raphaelchang/battman-hardware/README.md

# Battman Hardware

PCB designs and firmware for Battman lithium ion battery management system
