raphaelchang/battman-hardware/BMS/Project Outputs for Battman/BOM/Bill of Materials-Battman.xls

Designator | Quantity | Manufacturer | PartNumber | PackageReference | Description | Layer
BOOT, RESET | 2.0 | C&K Components | PTS810 SJM 250 SMTR LFS | PTS810 | Switch, SPNO Push Button SMD | Top
C1, C3, C4, C26, C33 | 5.0 | Murata | GRM155R70J105KA12D | 0402 | 1uF 6.3V 10% 0402 (1005 Metric) | Top
C2, C23_1, C23_2, C23_3, C23_4, C23_5, C23_6, C23_7, C23_8, C23_9, C23_10, C23_11, C23_12, C38, C39 | 15.0 | Murata | GRM155R62A104KE14D | 0402 | 0.1uF 100V 10% 0402 (1005 Metric) | Top
C5, C13, C14, C32, C34, C35, C40, C41, C42 | 9.0 | Murata | GRM155R70J104KA01D | 0402 | 0.1uF 6.3V 10% 0402 (1005 Metric) | Bottom, Top, Bottom, Bottom, Bottom, Bottom, Bottom, Bottom, Bottom
C6 | 1.0 | Murata | GRM155R60J475ME47D | 0402 | 4.7uF 6.3V 20% 0402 (1005 Metric) | Bottom
C7, C8 | 2.0 | Murata | GRM1555C1H150JA01D | 0402 | 15pF 50V 5% 0402 (1005 Metric) | Bottom
C9, C10, C11, C12, C15 | 5.0 | Murata | GRM155R60J225ME15D | 0402 | 2.2uF 6.3V 20% 0402 (1005 Metric) | Bottom
C16, C17, C18, C19 | 4.0 | Murata | GRM188R6YA106MA73D | 0603 | 10uF 35V 10% 0603 (1608 Metric) | Top
C20, C21 | 2.0 | Taiyo Yuden | UMK316BBJ106ML-T | 1206 | 10uF 50V 20% 1206 (3216 Metric) | Top
C22 | 1.0 | Nichicon | PCR1H181MCL1GS | 1H | 180uF 50V 20% | Top
C23 | 1.0 | Murata | GCM155R71H222KA37D | 0402 | 2.2nF 50V 10% 0402 (1005 Metric) | Top
C24 | 1.0 | Murata | GRJ32DC72A475KE11L | 1210 | 4.7uF 100V 10% 1210 (3225 Metric) | Top
C25 | 1.0 | Murata | GRM155R71H332KA01D | 0402 | 3.3nF 50V 10% 0402 (1005 Metric) | Top
C27 | 1.0 | Murata | GRM32ER70J476KE20L | 1210 | 47uF 6.3V 10% 1210 (3225 Metric) | Top
C28, C29 | 2.0 | Murata | GRM155R60J106ME44D | 0402 | 10uF 6.3V 20% 0402 (1005 Metric) | Bottom
C30 | 1.0 | Murata | GRM188R61H105KAALD | 0603 | 1uF 50V 10% 0603 (1608 Metric) | Bottom
C31, C36 | 2.0 | TDK | C1005X7S2A103K050BB | 0402 | 10nF 100V 10% 0402 (1005 Metric) | Bottom
C37 | 1.0 | Murata | GRM1555C1H102JA01D | 0402 | 1nF 50V 5% 0402 (1005 Metric) | Top
D1 | 1.0 | Central Semiconductor | CMHZ5265B TR | SOD-123 | Zener Diodes 500mW Zener Diode 185mA 58.9V to 2V | Top
D2 | 1.0 | SunLED | XZMDKCBDDG45S-9 | 4-PLCC |  | Bottom
D3 | 1.0 | NXP | PTVS51VS1UTR,115 | SOD-123W |  | Bottom
D4, D7, D13, D19 | 4.0 | Lite-On Inc. | LTST-C193TGKT-5A | 0603 |  | Top
D5 | 1.0 | Fairchild Semiconductor | FSV10120V | TO-277-3 | Schottky Diodes & Rectifiers 10 Amp 120V Schottky Rectifier | Top
D6, D16, D17 | 3.0 | Vishay | SMAJ51A-E3/61 | DO-214AC |  | Bottom
D8_1, D8_2, D8_3, D8_4, D8_5, D8_6, D8_7, D8_8, D8_9, D8_10, D8_11, D8_12 | 12.0 | ON Semiconductor | MM3Z12VT1G | SOD-323 | Zener Voltage Regulator, 300 mW, 2-Pin SOD-323, Tape and Reel | Top
D9_1, D9_2, D9_3, D9_4, D9_5, D9_6, D9_7, D9_8, D9_9, D9_10, D9_11, D9_12 | 12.0 | Lite-On Inc. | LTST-C193TBKT-5A | 0603 |  | Top
D10, D11 | 2.0 | NXP Semiconductors | PMEG6020ER,115 | SOD-123W |  | Top
D12, D15, D18 | 3.0 | Littelfuse | SP4021-01FTG | SOD-323-2 |  | Bottom
D14 | 1.0 | Littelfuse | SP4020-01FTG | SOD-323-2 |  | Bottom
F1, F2, F3, F4, F5, F6 | 6.0 | Schurter | 3413.0332.22 | 1206 | Surface Mount Fuses UST 1206 FUSE 25A F | Bottom
JP1 | 1.0 | JST Sales America, Inc. | B13B-XH-A(LF)(SN) | JST-XH |  | Top
JP2, JP3, JP4 | 3.0 | JST Sales America, Inc. | B2B-PH-K-S(LF)(SN) | JST-PH |  | Top
JP5 | 1.0 | JST Sales America, Inc. | B5B-PH-K-S(LF)(SN) | JST-PH |  | Top
JP6 | 1.0 | Amphenol FCI | 10118192-0001LF | USB - Micro B |  | Top
L1 | 1.0 | Murata | BLM31PG330SN1L | 1206 | EMI Filter Beads, Chips & Arrays 1206 33 OHM | Top
L2 | 1.0 | Bourns | SRP1038A-220M | SRP1038A | 22uH 20% 7A 1038 | Top
L3 | 1.0 | Bourns | SDR0604-220YL | SDR0604 | 22uH 30% 1.1A 0604 | Top
L4 | 1.0 | Murata | LQM21PN2R2MGHL | 0805 | 2.2uH 20% 1.7A 0805 | Bottom
LS1 | 1.0 | CUI, Inc. | CSS-0575A-SMT | 5x5x1.9mm | Magnetic Buzzer Transducer | Bottom
Q1, Q8, Q10, Q11, Q12, Q13 | 6.0 | Diodes Incorporated | BSS123WQ-7-F | SOT-323-3 | N-Channel MOSFET | Bottom
Q2 | 1.0 | Vishay | SIR664DP-T1-GE3 | PowerPAK-8 | N-Channel MOSFET | Top
Q3_1, Q3_2, Q3_3, Q3_4, Q3_5, Q3_6, Q3_7, Q3_8, Q3_9, Q3_10, Q3_11, Q3_12, Q9 | 13.0 | Infineon | BSS84PWH6327XTSA1 | SOT323-3 | P-Channel MOSFET | Bottom
Q4 | 1.0 | Infineon Technologies | IRF7749L1TRPBF | DIRECTFET L8 | N-Channel MOSFET | Bottom
Q5, Q7 | 2.0 | Vishay | SI2309CDS-T1-GE3 | SOT23-3 | P-Channel MOSFET | Top
Q6 | 1.0 | Vishay | SIS862DN-T1-GE3 | PowerPAK-1212-8 | N-Channel MOSFET | Top
R1, R2, R3, R6, R7, R9 | 6.0 | KOA Speer | RK73H1ETTP1004F | 0402 | 1M 0.063W 1% 0402 (1005 Metric) | Top
R4 | 1.0 | KOA Speer | RK73H1ETTP1003F | 0402 | 100K 0.063W 1% 0402 (1005 Metric) | Bottom
R5, R10, R34_1, R34_2, R34_3, R34_4, R34_5, R34_6, R34_7, R34_8, R34_9, R34_10, R34_11, R34_12, R36_1, R36_2, R36_3, R36_4, R36_5, R36_6, R36_7, R36_8, R36_9, R36_10, R36_11, R36_12, R50, R51 | 28.0 | KOA Speer | RK73H1ETTP1000F | 0402 | 100R 0.063W 1% 0402 (1005 Metric) | Top, Bottom, Top, Top, Top, Top, Top, Top, Top, Top, Top, Top, Top, Top, Top, Top, Top, Top, Top, Top, Top, Top, Top, Top, Top, Top, Bottom, Bottom
R8 | 1.0 | KOA Speer | RK73H1ETTP1001F | 0402 | 1K 0.063W 1% 0402 (1005 Metric) | Bottom
R11, R12 | 2.0 | KOA Speer | RK73H1ETTP22R0F | 0402 | 22R 0.063W 1% 0402 (1005 Metric) | Bottom
R13 | 1.0 | KOA Speer | RK73H1ETTP1501F | 0402 | 1K5 0.063W 1% 0402 (1005 Metric) | Bottom
R14, R19, R23, R24, R28, R41, R44, R45, R47, R48, R59, R61 | 12.0 | KOA Speer | RK73H1ETTP1002F | 0402 | 10K 0.063W 1% 0402 (1005 Metric) | Bottom, Top, Bottom, Top, Top, Bottom, Bottom, Bottom, Bottom, Bottom, Bottom, Bottom
R15, R16 | 2.0 | KOA Speer | RK73H1ETTP2201F | 0402 | 2K2 0.063W 1% 0402 (1005 Metric) | Bottom
R17, R18, R40, R52, R62 | 5.0 | KOA Speer | RK73H1ETTP4701F | 0402 | 4K7 0.063W 1% 0402 (1005 Metric) | Bottom
R20, R21 | 2.0 | KOA Speer | RK73H1ETTP4R70F | 0402 | 4R7 0.063W 1% 0402 (1005 Metric) | Bottom
R22, R32 | 2.0 | KOA Speer | RK73H1ETTP2003F | 0402 | 200K 0.063W 1% 0402 (1005 Metric) | Bottom
R25 | 1.0 | Murata | NCP15XH103D03RC | 0402 | NTC 10K 0.5% 0402 (1005 Metric) | Top
R26 | 1.0 | KOA Speer | RK73H1ETTP68R0F | 0402 | 68R 0.063W 1% 0402 (1005 Metric) | Bottom
R27, R57, R60 | 3.0 | Vishay | RCS060310K0FKEA | 0603 | 10K 0.25W 1% 0603 (1005 Metric) | Bottom
R29 | 1.0 | Vishay | RCP0603W2K00GEB | 0603 | 2K 1.5W 2% 0603 (1005 Metric) | Top
R30 | 1.0 | KOA Speer | RK73H1ETTP6981F | 0402 | 6K98 0.063W 1% 0402 (1005 Metric) | Bottom
R31 | 1.0 | Panasonic | ERJ-8CWFR016V | 1206 | 0.016R 1W 1% 1206 (3216 Metric) | Top
R33 | 1.0 | KOA Speer | RK73H1ETTP1502F | 0402 | 15K 0.063W 1% 0402 (1005 Metric) | Bottom
R35_1, R35_2, R35_3, R35_4, R35_5, R35_6, R35_7, R35_8, R35_9, R35_10, R35_11, R35_12 | 12.0 | Panasonic | ERJ-P06J470V | 0805 | 47R 0.5W 5% 0805 (2012 Metric) | Bottom
R37 | 1.0 | KOA Speer | RK73H1ETTP1500F | 0402 | 150R 0.063W 1% 0402 (1005 Metric) | Bottom
R38 | 1.0 | KOA Speer | RK73H1ETTP5102F | 0402 | 51K 0.063W 1% 0402 (1005 Metric) | Bottom
R39, R46, R49 | 3.0 | KOA Speer | RK73H1ETTP1802F | 0402 | 18K 0.063W 1% 0402 (1005 Metric) | Bottom
R42, R43 | 2.0 | Vishay | RCP1206W50R0GEB | 1206 | 50R 2.4W 2% 1206 (3216 Metric) | Top
R53 | 1.0 | Vishay / Dale | WSLP2726L5000FEA | 2726 | Current Sense Resistor, 0.0005R | Top
R54, R55, R56 | 3.0 | KOA Speer | RK73H1ETTP1005F | 0402 | 10M 0.063W 1% 0402 (1005 Metric) | Top
R58 | 1.0 | KOA Speer | RK73H1ETTP1200F | 0402 | 120R 0.063W 1% 0402 (1005 Metric) | Bottom
U1 | 1.0 | Linear Technology | LTC6803IG-3#PBF | TSSOP-44 |  | Top
U2 | 1.0 | STMicroelectronics | STM32F303CBT6 | LQFP-48 |  | Bottom
U3 | 1.0 | Linear Technology | LTC3873ETS8-5#PBF | TSOT-23-8 |  | Top
U4 | 1.0 | Maxim Integrated | MAX5215GUA+ | MSOP-8 | 14 Bit Digital to Analog Converter | Bottom
U5 | 1.0 | Maxim Integrated | MAX17502FATB+T | TDFN-10-EP | Ultra-Small, High-Efficiency, Synchronous Step-Down DC-DC Converter, 4.5 to 60 V, 1 A, -40 to 125 degC, 10-Pin TDFN (T1032N+1), RoHS, Tape and Reel | Top
U6 | 1.0 | Texas Instruments | TPS62291DRVR | WSON-6 | Voltage Regulators - Switching Regulators 2.25MHz 1A Step-Down Cnvrtr 3.3V Output | Bottom
U7 | 1.0 | Texas Instruments | BQ76200PWR | TSSOP-16 | Battery Management Fast high side NCH drive | Bottom
U8 | 1.0 | Texas Instruments | TCAN332DCNR | SOT-23-8 | CAN Interface IC 3.3-V CAN Transceivers with CAN FD (Flexible Data Rate) 8-SOT-23 -40 to 125 | Bottom
U9 | 1.0 | Intersil | ISL28022FUZ-T7A | MSOP-10 |  | Top
U10 | 1.0 | Texas Instruments | PCF85263ATT/AJ | TSSOP-8 | Real Time Clock Real-Time Clock calendar | Bottom
U11 | 1.0 | Macronix | MX25R1635FZUIH0 | USON-8 |  | Bottom
Y1 | 1.0 | ABRACON | ABM3B-8.000MHZ-10-1UT | 2012 |  | Bottom
Y2 | 1.0 | AVX/Kyocera | ST3215SB32768B0HPWB3 | ST3215SB | 32.768kHz ±20ppm Crystal 6pF 60 kOhm -40°C ~ 85°C Surface Mount 2-SMD, No Lead (DFN, LCC) | Bottom
