raphaelchang/battman-hardware/OldVersions/V1/pcb/BMS/BMS.step

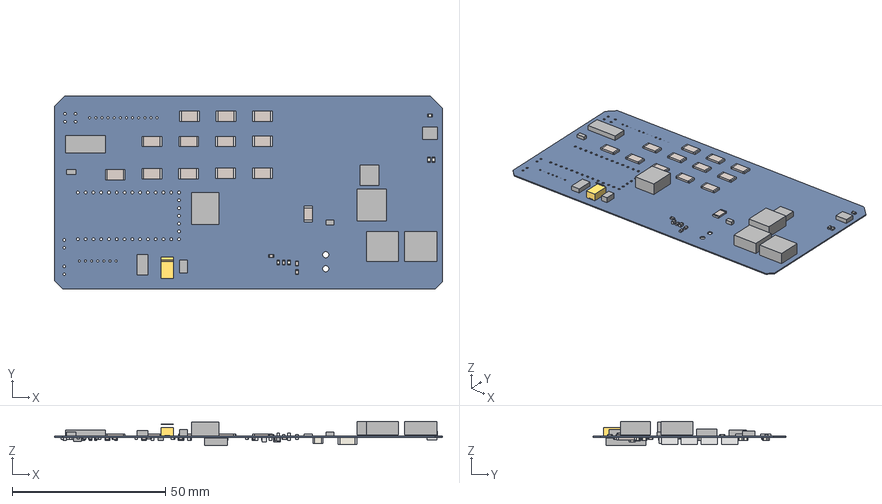
[picture p1: CAD file, 2016-06-15, an earlier design]
OldVersions/V1/pcb/BMS/BMS.step
126.6 x 63.0 x 7.89 mm
Board
Extruded x 319
