raphaelchang/battman-hardware/OldVersions/V3/BMS.step

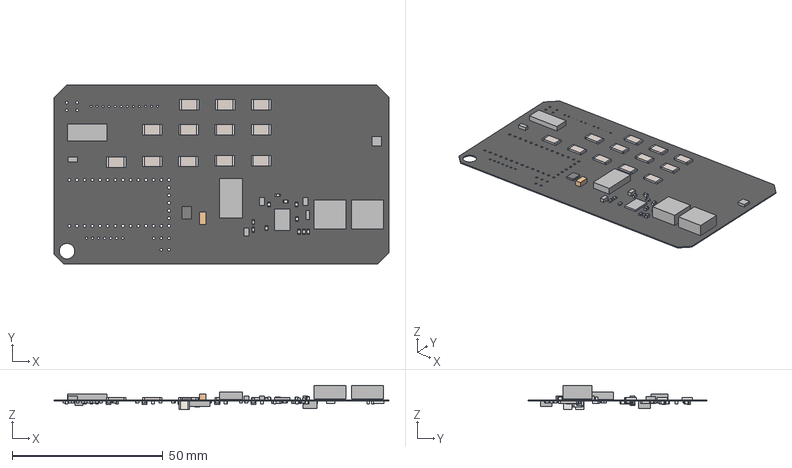
[picture p2: CAD file, 2016-06-15, an earlier design]
OldVersions/V3/BMS.step
111.0 x 59.4 x 8.04 mm
Board
Extruded x 351
User_Library-DFN-12_Leads
User_Library-DFN-12_ComponentBody
