raphaelchang/battman-hardware/(threads)

Thread 1 (2016-09-21):

Is this functional?

pascoej, 2016-09-21:
Does V3 actually work?

brentyi, 2016-09-21:
@pascoej the hardware's pretty much there, but we're working hard on stress testing + firmware development (switched microcontrollers) and won't be releasing until that's all done.

Check back in a few months!

Closed 2016-11-12.

Thread 2 (2016-10-12):

Export as Eagle-friendly ACCEL-ASCII

27percent, 2016-10-12:
Hi there!

I'm really enjoying following this project, the progress you've made over the past couple of weeks is crazy impressive, can't wait to see if the 4.0 PCBs work out!

Since your goal for this project is to be an hobbyist-friendly open-source BMS, could you possibly export the designs from Altium as ACCEL-ASCII or another Eagle compatible format? For better or worse, EagleCAD has become is the de facto standard for open source projects, so it'd be great if eagle-compatible files were available for people to take a look at and base their own designs off :)

raphaelchang, 2016-10-22:
I've added a .PCB file in the project outputs folder, which should be usable by Eagle. I still haven't found a way to export the schematics.

Closed 2016-11-12.

Thread 3 (2017-08-29):

More room between wire pads

Peemouse, 2017-08-29:
Soldering pads are too close for safe soldering and operation in a hard environnement (vibration, shock...) that may result into shorts.

Please, make more room between pads or split them to different place on the board.
This is a major issue and may result is serious hazard.

Thread 4 (2017-08-29):

Protect board from wrong connecting order

Peemouse, 2017-08-29:
As you mention, we need to connect battery first and then balance plugs.
Not respecting this procedure results into frying component on the board.

Please, improve this point to make the board more robust to any wiring order (this would happen a lot).

Thread 6 (2018-03-27):

Specifications

happytm, 2018-03-27:
What are the specifications for this board? specially compared to http://electrodacus.com/SBMS100/manual/SBMSmanual.pdf

brentyi, 2018-03-27:
We haven't actively pushed the limits of the board, but the components are specced for:
- 100A continuous discharge, 150A peak
- Support for 4S ~ 12S lithium batteries
- 100mA balancing current
- CC/CV charging at 6A

happytm, 2018-03-27:
Thanks
