raphaelchang/battman-hardware/OldVersions/V3/BMS.pdf

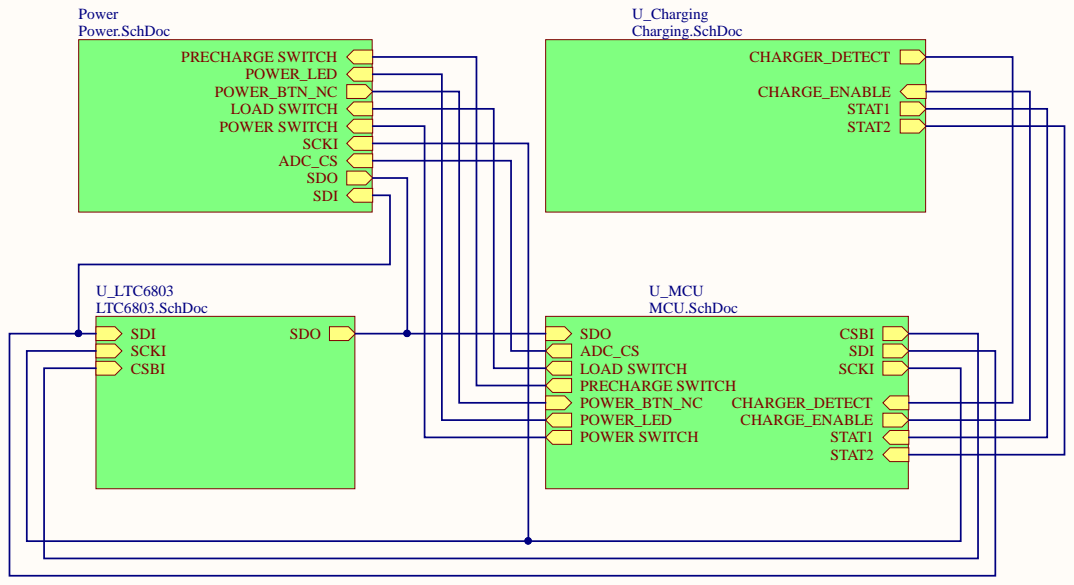
[picture p3: page 1]

Raphael Chang & Brent Yi

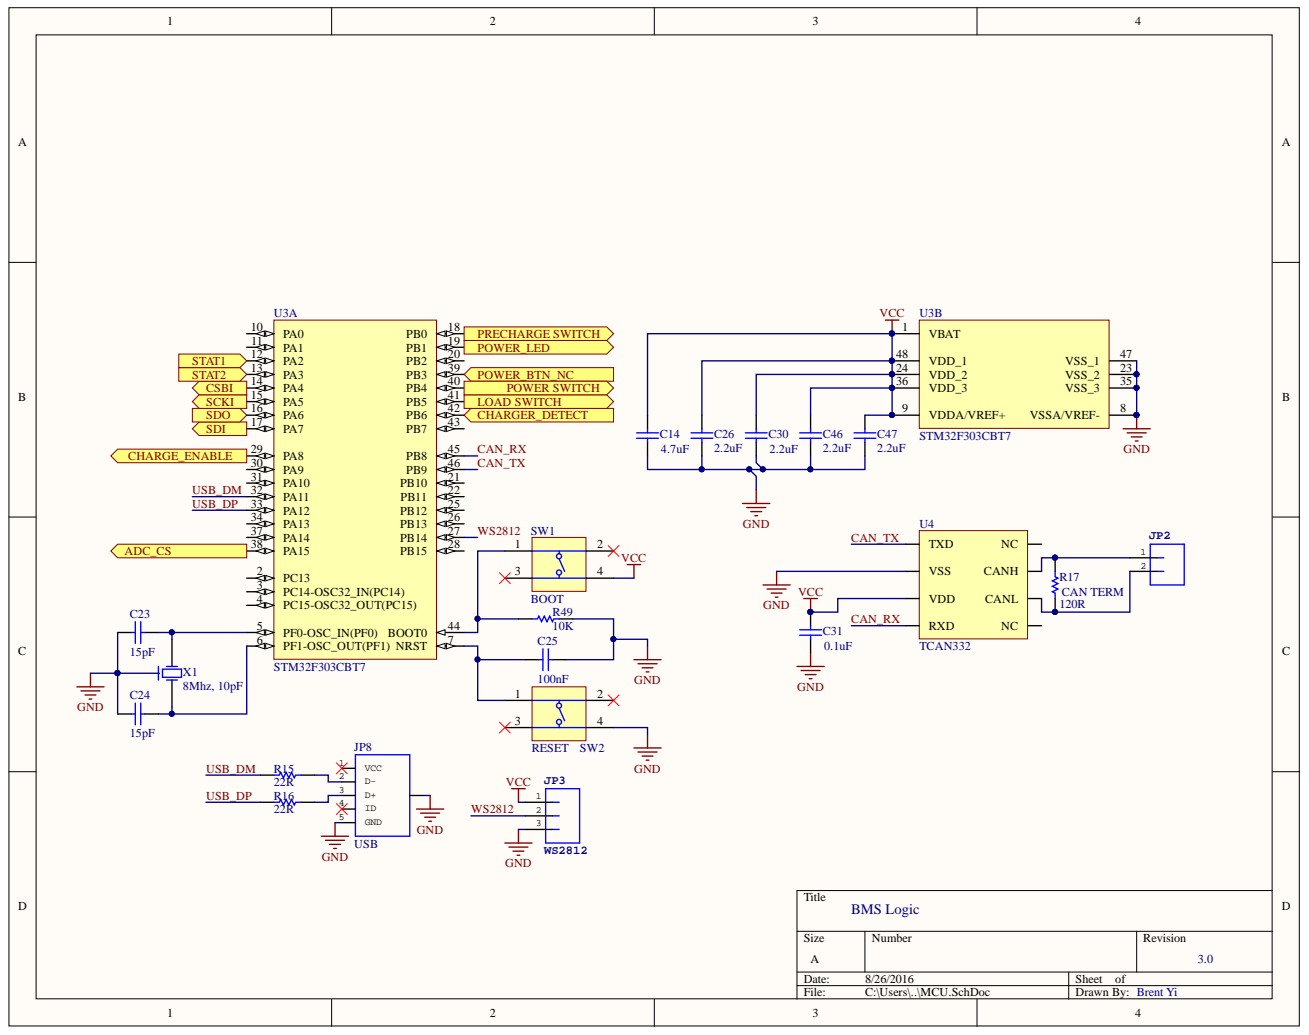
[picture p4: page 2]

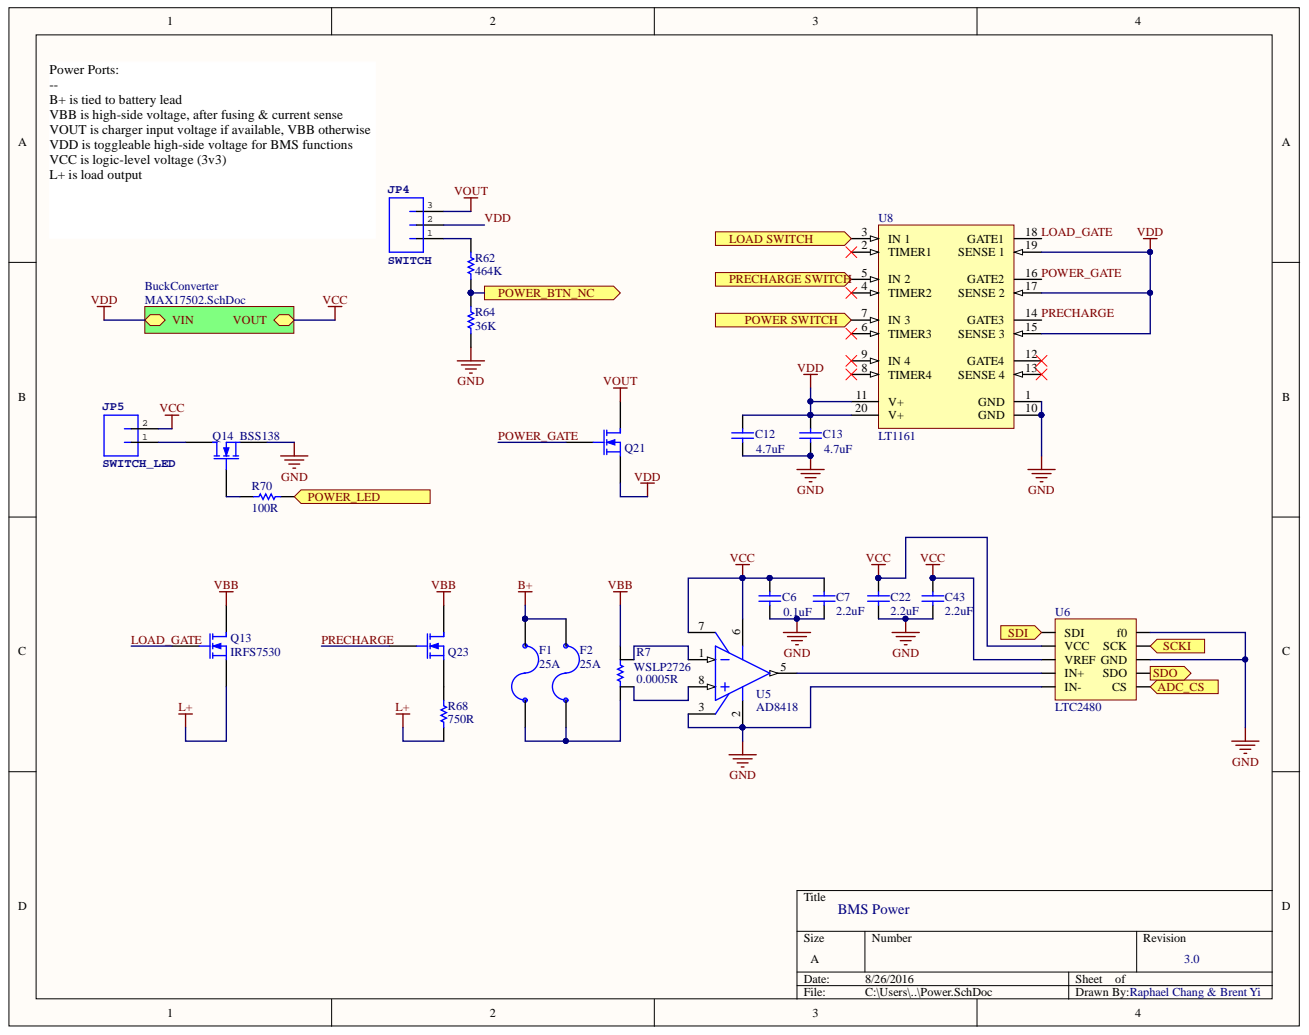
[picture p5: page 3]

Power Ports:
B+ is tied to battery lead
VBB is high-side voltage, after fusing & current sense
VOUT is charger input voltage if available, VBB otherwise
VDD is toggleable high-side voltage for BMS functions
VCC is logic-level voltage (3v3)
L+ is load output

Raphael Chang & Brent Yi

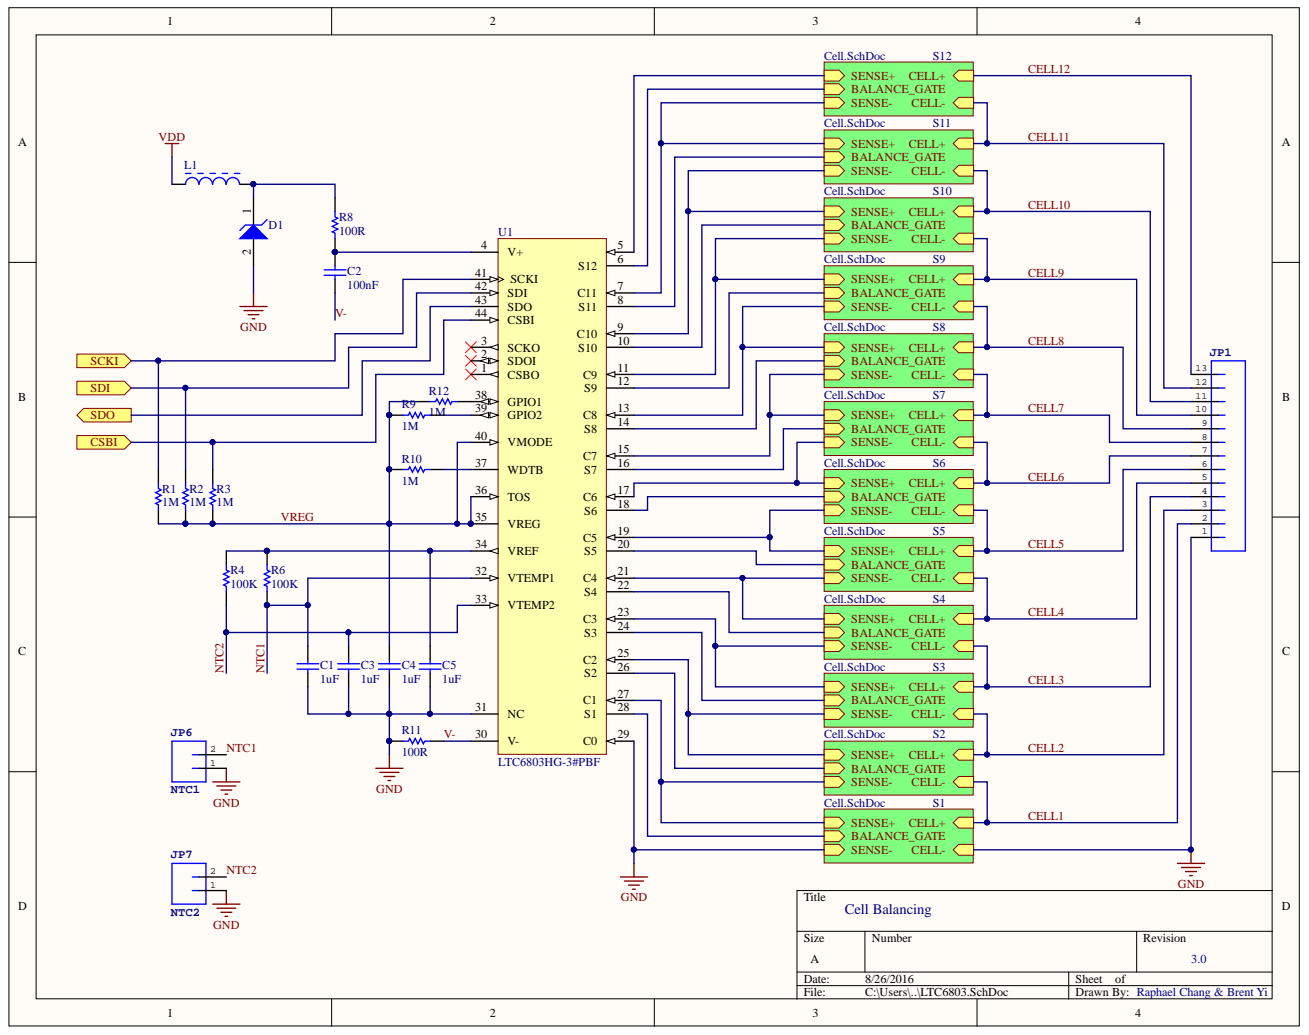
[picture p6: page 4]

6 | | Ce l l . S chDoc S 9
7 | | S E N S E + CE L L + BA L A NCE_G AT E S E N S E -CE L L -

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

Ce l l . S chDoc S 7

Ce l l . S chDoc S 6
S E N S E + CE L L + BA L A NCE_G AT E S E N S E -CE L L -Ce l l . S chDoc S 5 S E N S E + CE L L + BA L A NCE_G AT E S E N S E -CE L L -

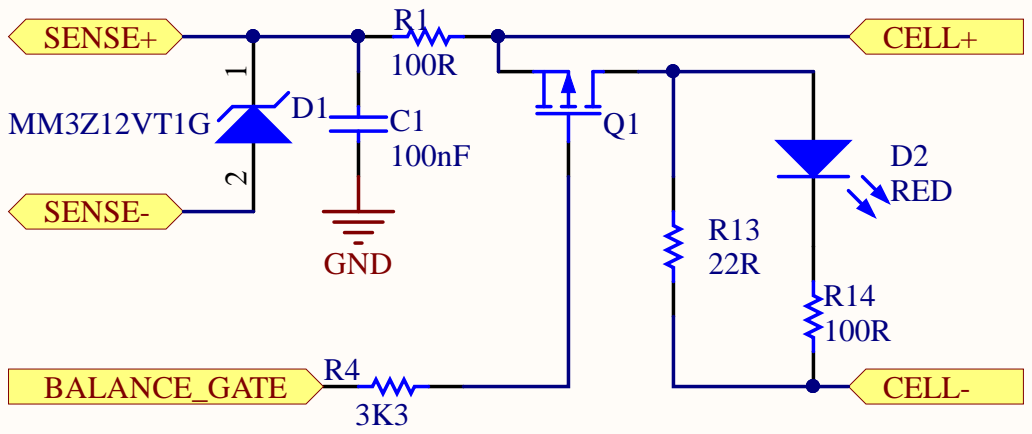
[picture p7: page 5]

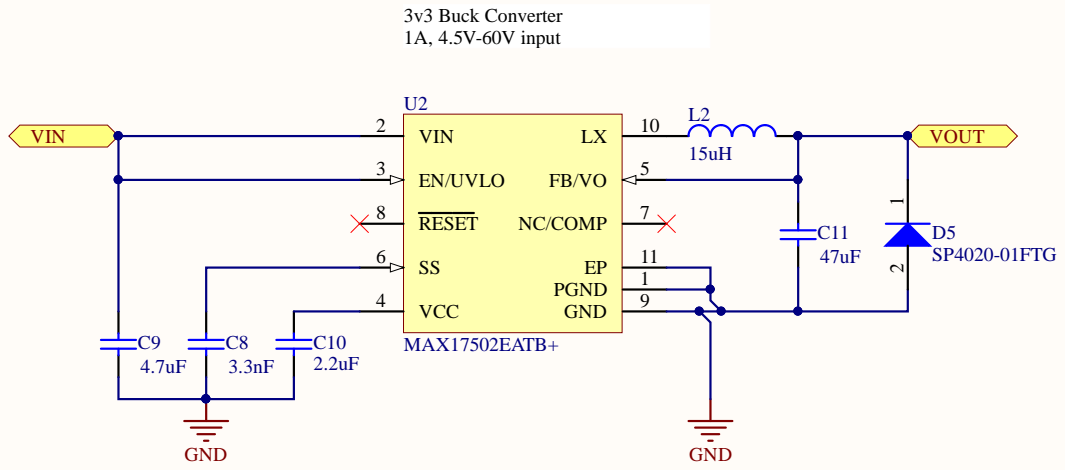
[picture p8: page 6]

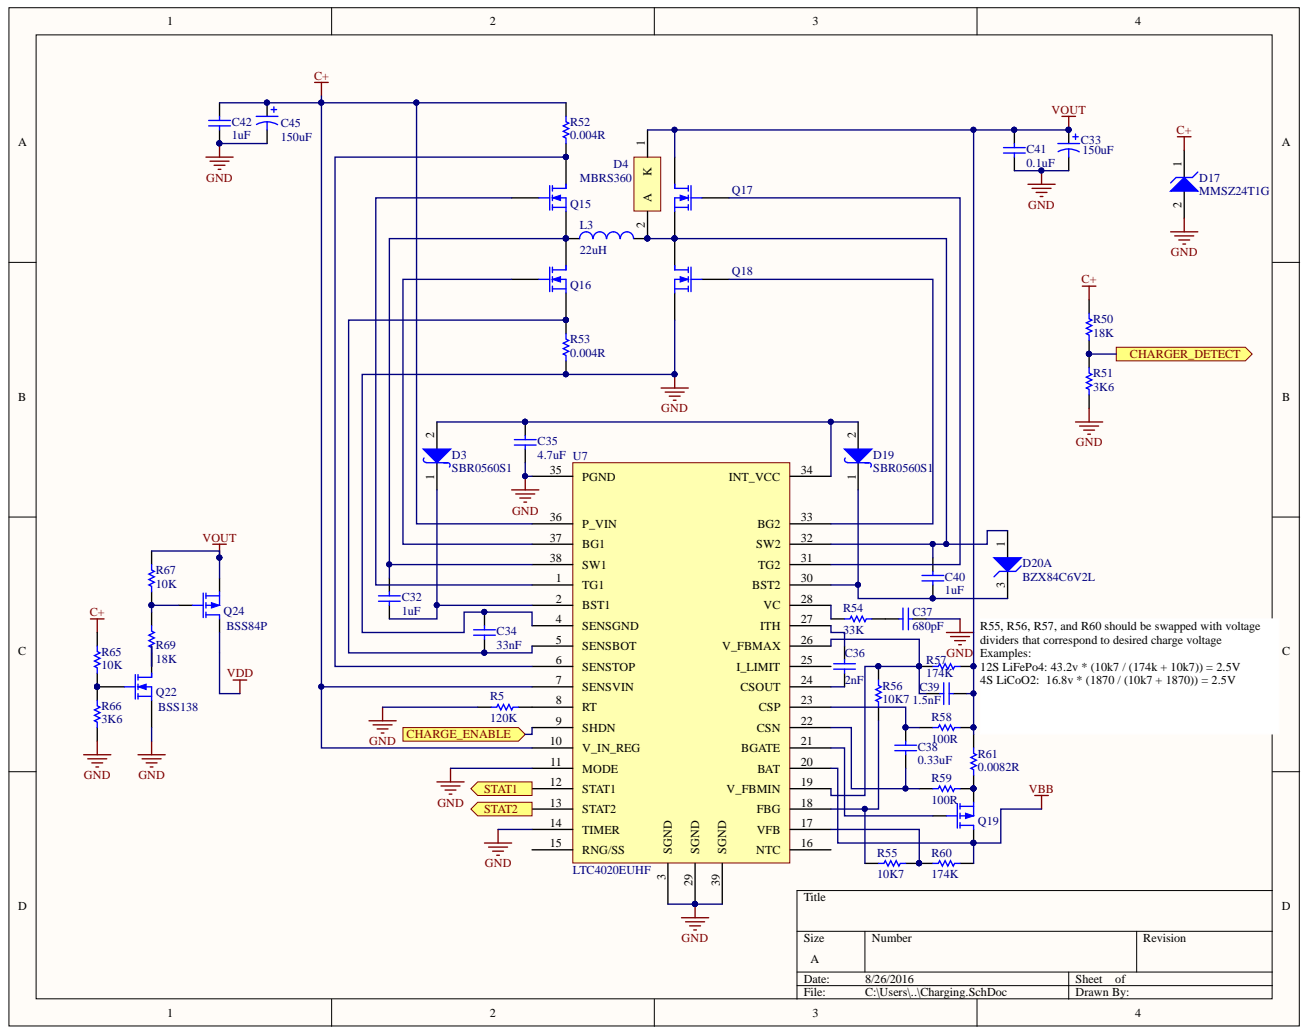
[picture p9: page 7]

BG 2 | 32
S W

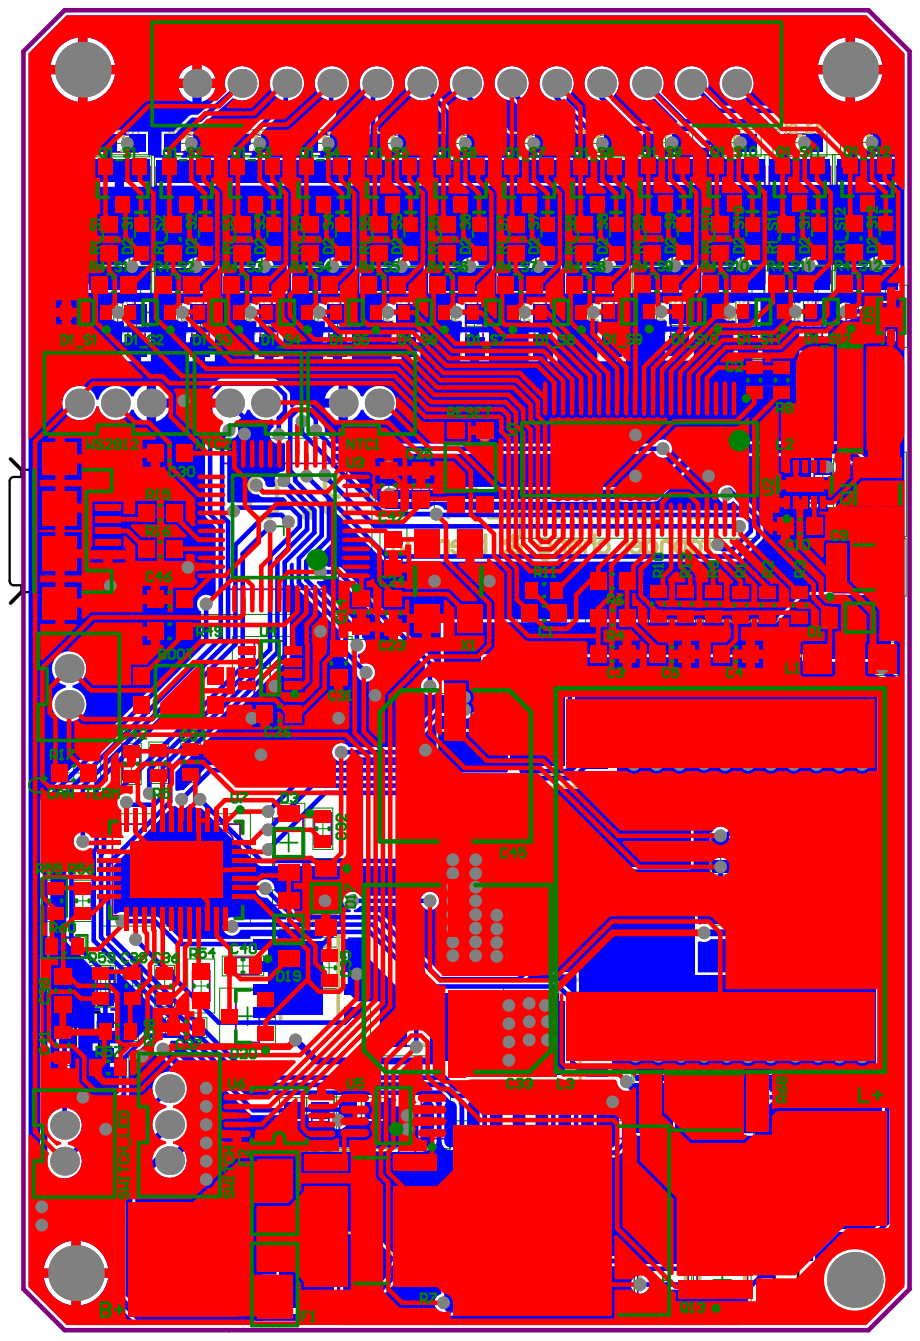
[picture p10: page 8]
