raphaelchang/battman-hardware/OldVersions/V4.1/Project Outputs for Battman/Battman.pdf

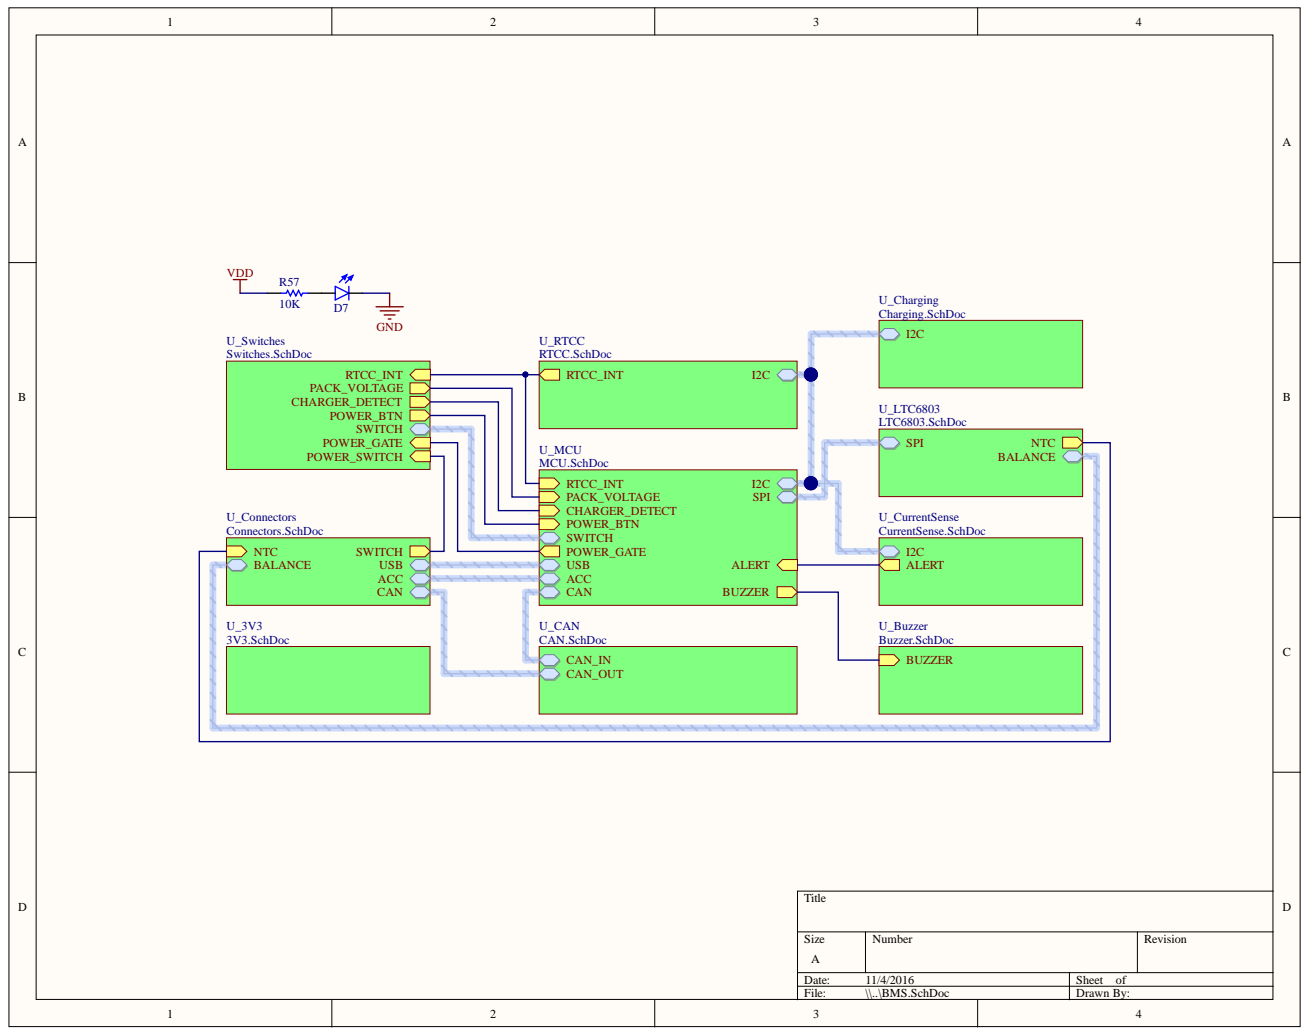
[picture p11: page 1]

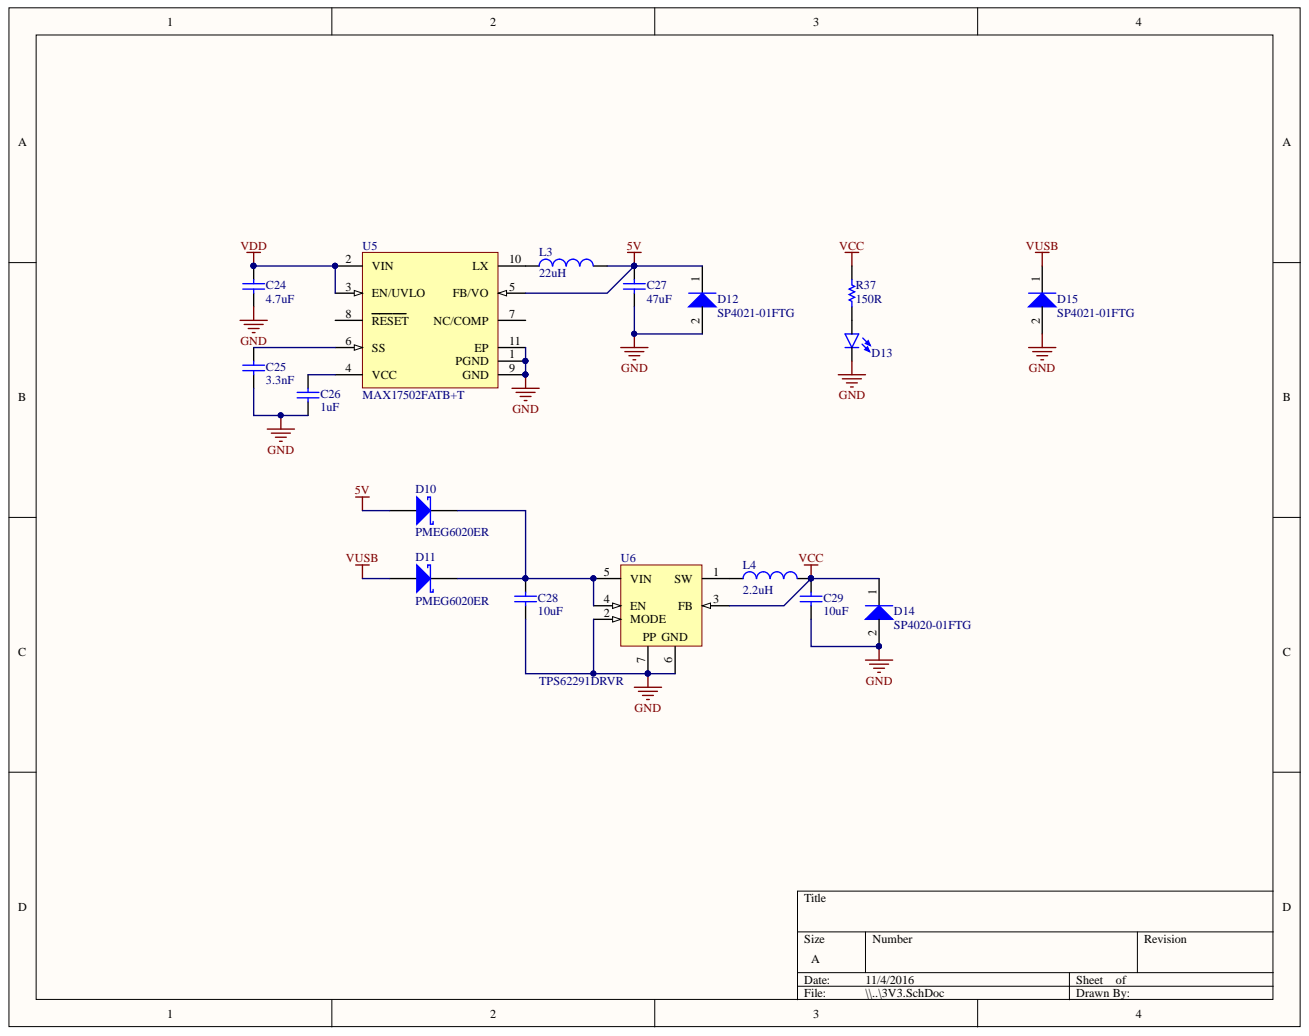
[picture p12: page 2]

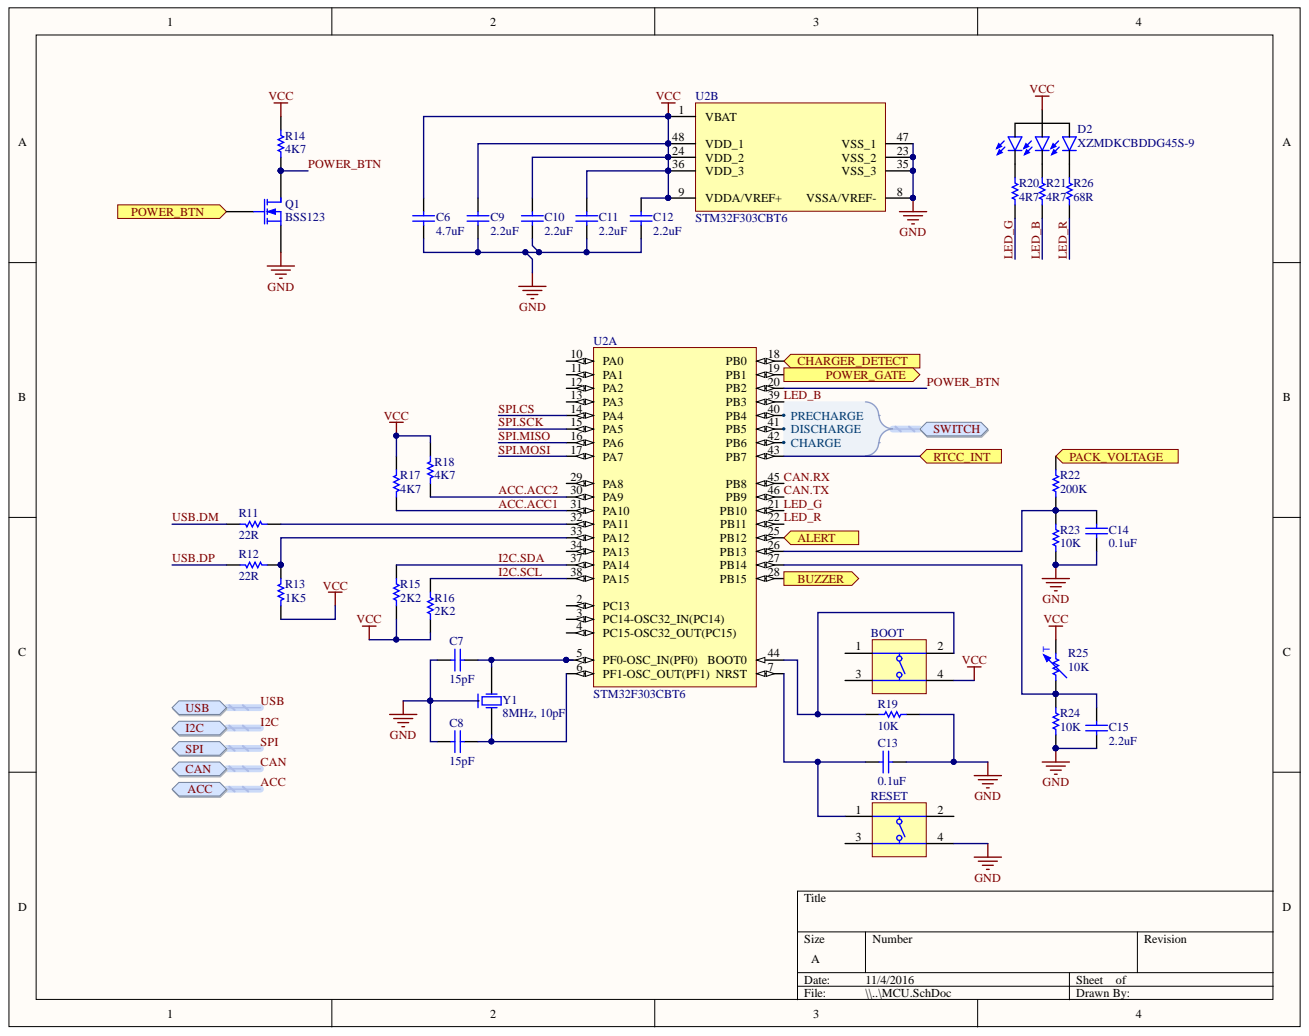
[picture p13: page 3]

PA11 32 | | R23 ALERT 10K

I2C.SDA | | PA13 34

I2C.SCL | PA15 38 | BUZZER

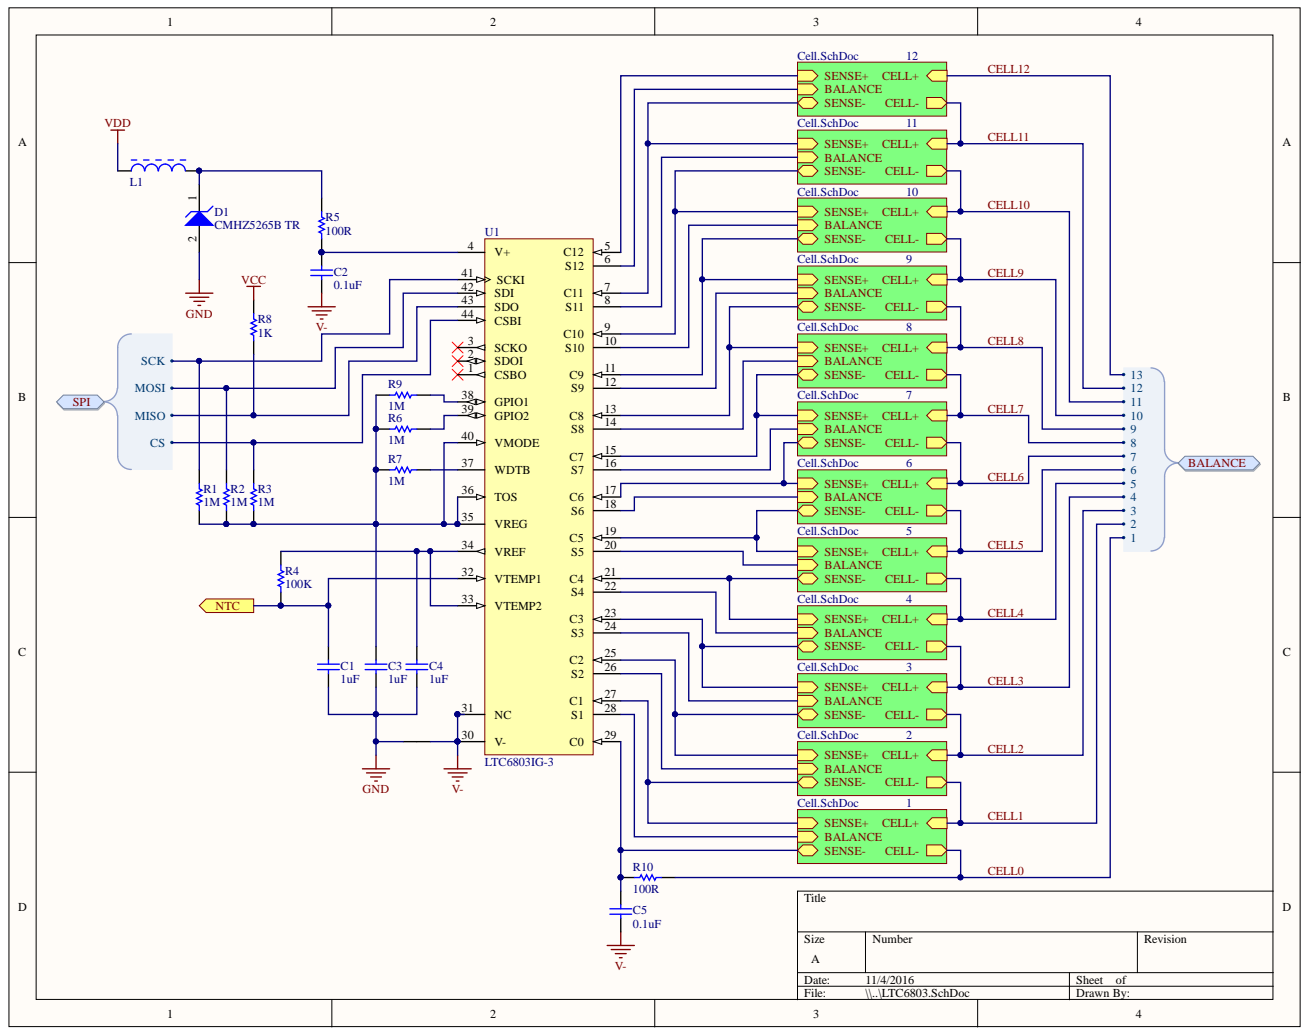
[picture p14: page 4]

6 | | Ce l l . S chDoc 9
7 | | CE L L + BALANCE CE L L -

S E N S E + CE L L + BA L A NCE S E N S E -CE L L -

Ce l l . S chDoc 7
S E N S E + CE L L + BA L A NCE S E N S E -CE L L - | CE L L 7

Ce l l . S chDoc 4

Ce l l . S chDoc 3

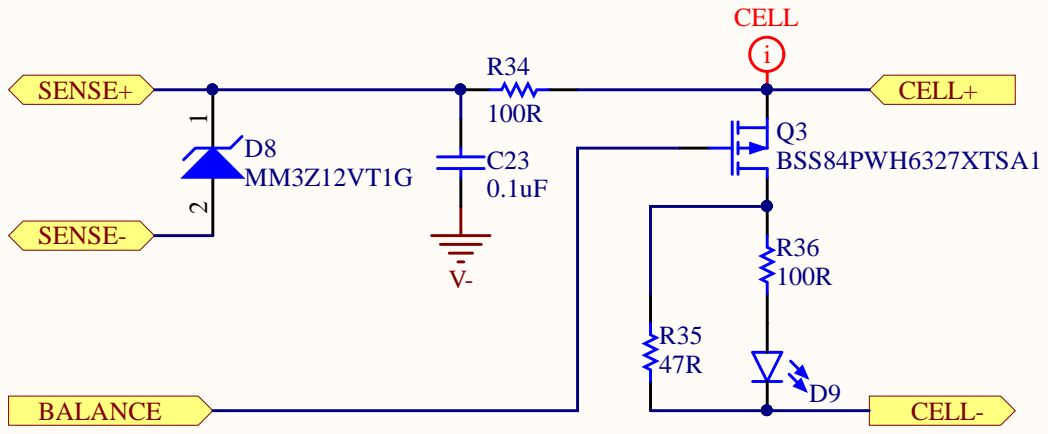
[picture p15: page 5]

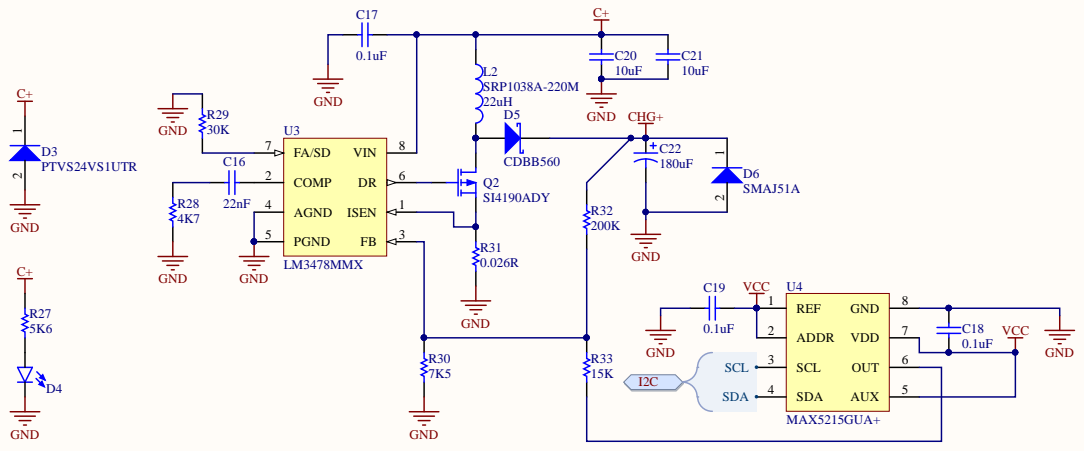
[picture p16: page 6]

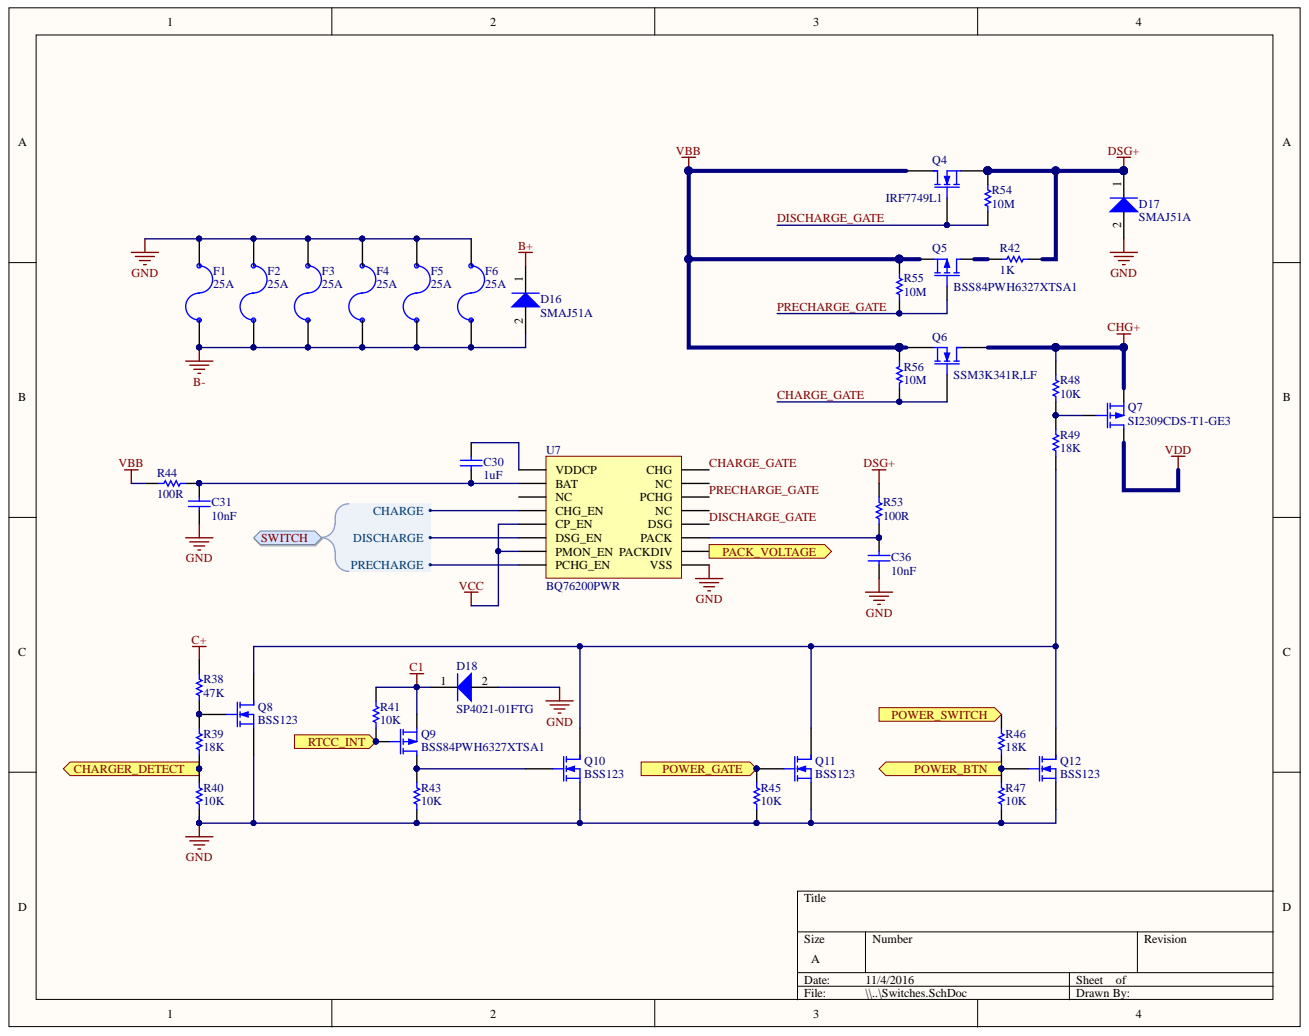
[picture p17: page 7]

PRECHARGE_GATE

C1 D18

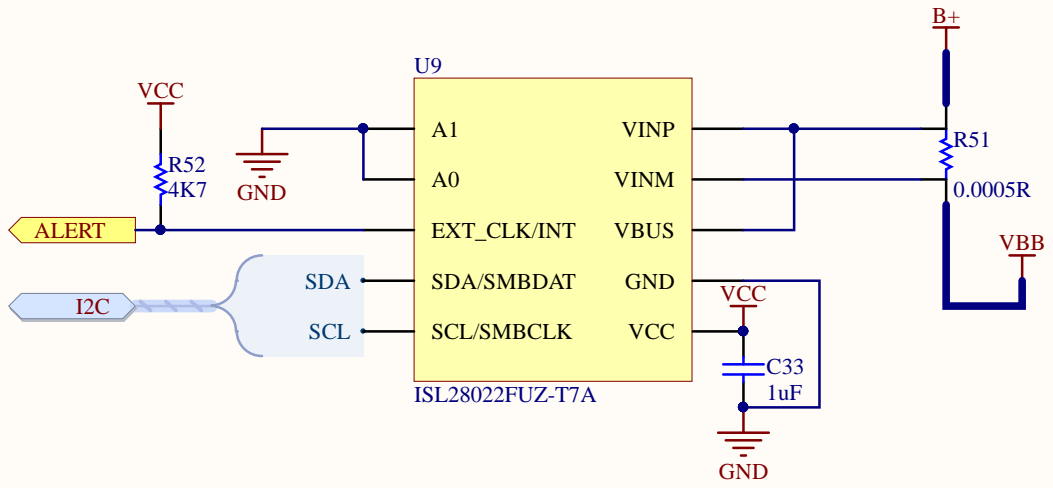
[picture p18: page 8]

VCC GND VBUS VINM VINP

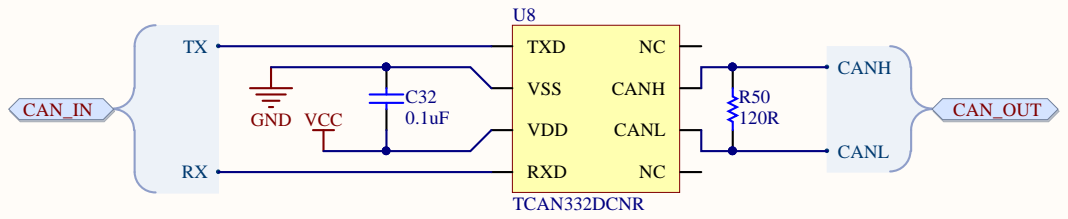
[picture p19: page 9]

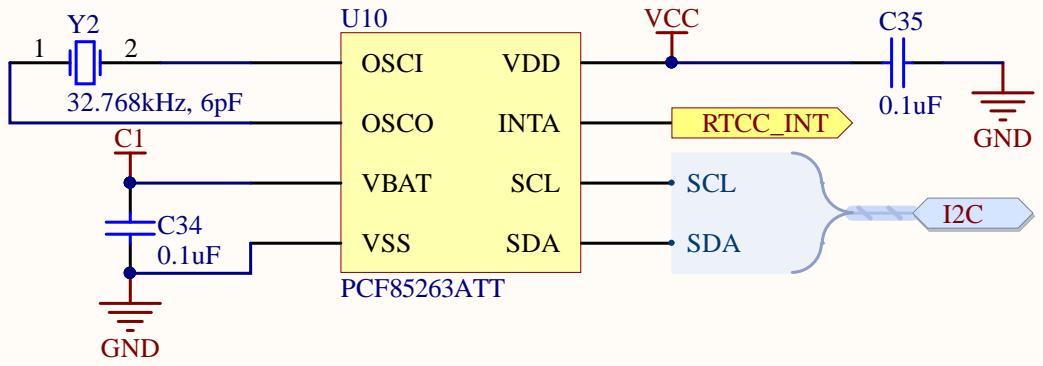
[picture p20: page 10]

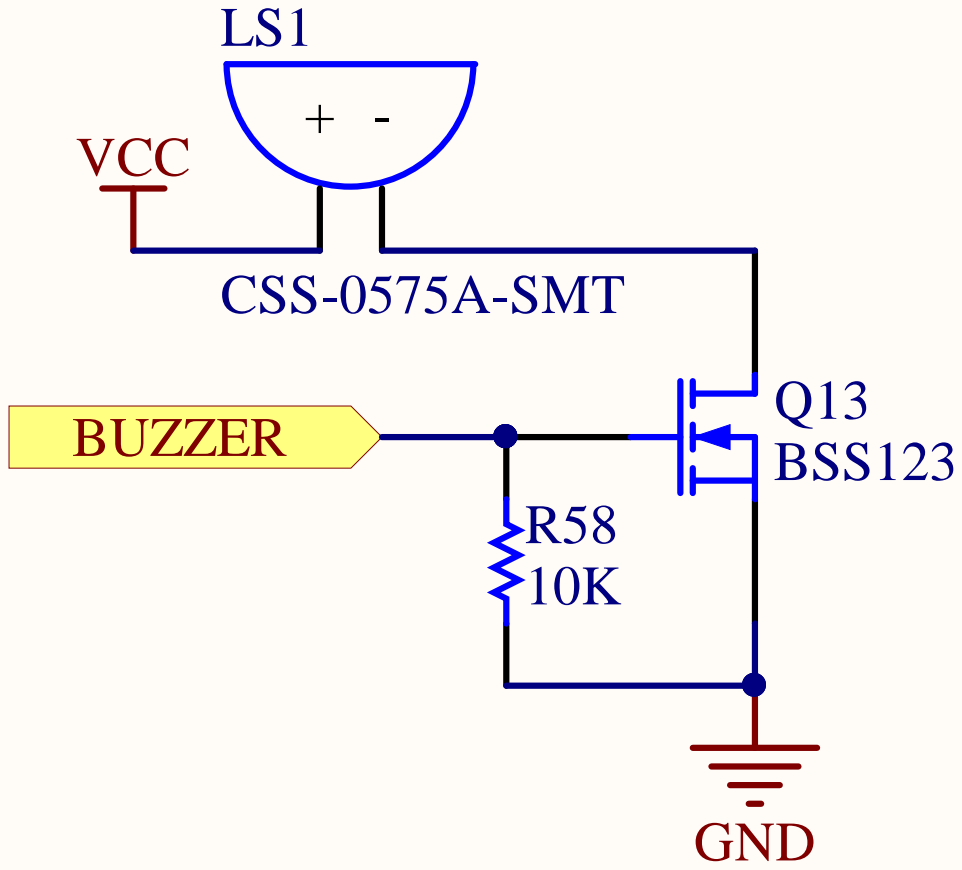
[picture p21: page 11]

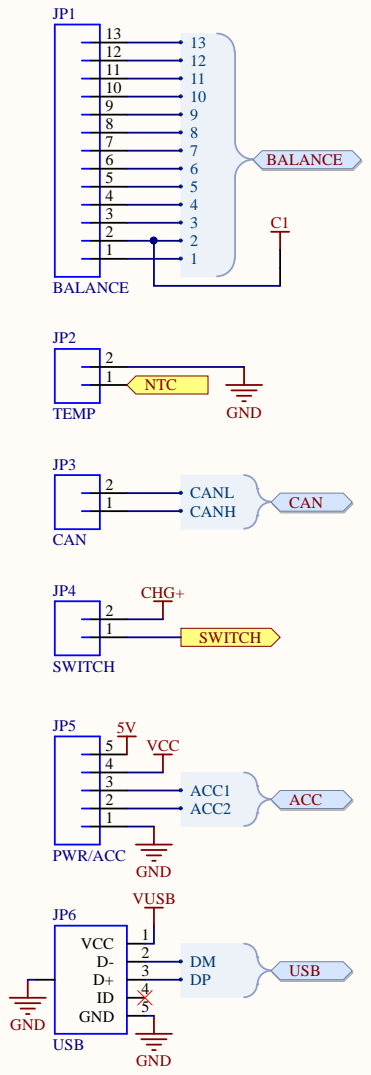
[picture p22: page 12]

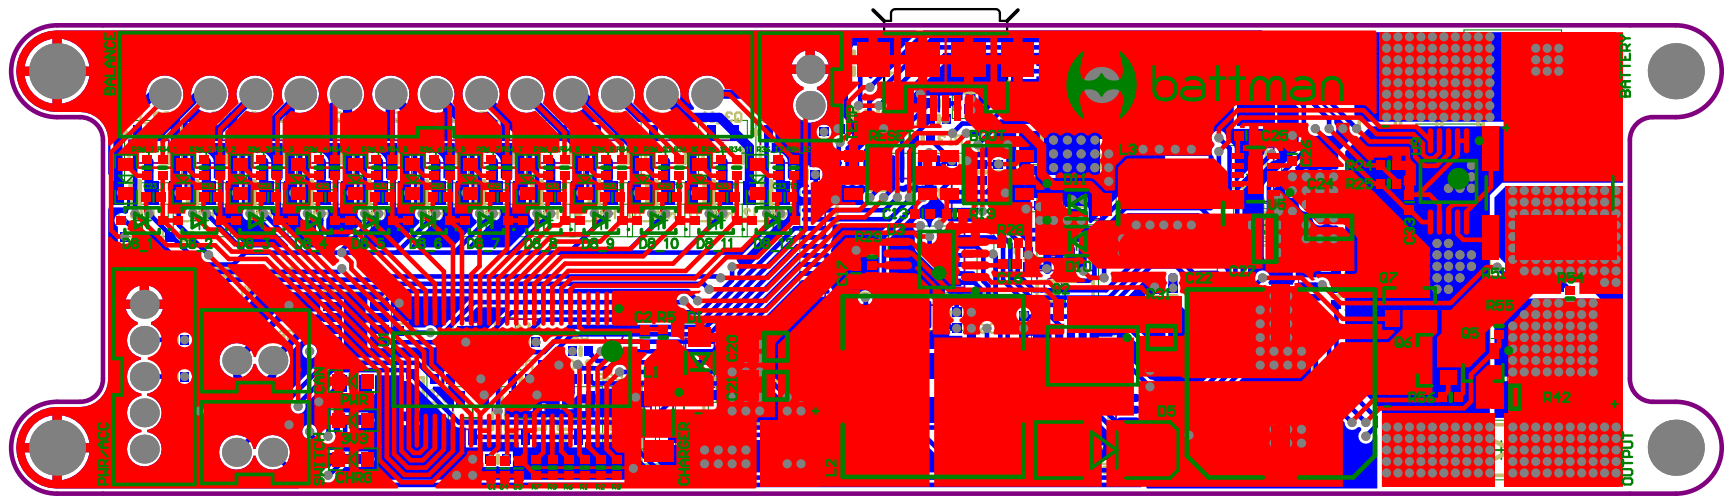
[picture p23: page 13]
