raphaelchang/battman-hardware/OldVersions/V4/Project Outputs for Battman/Battman.pdf

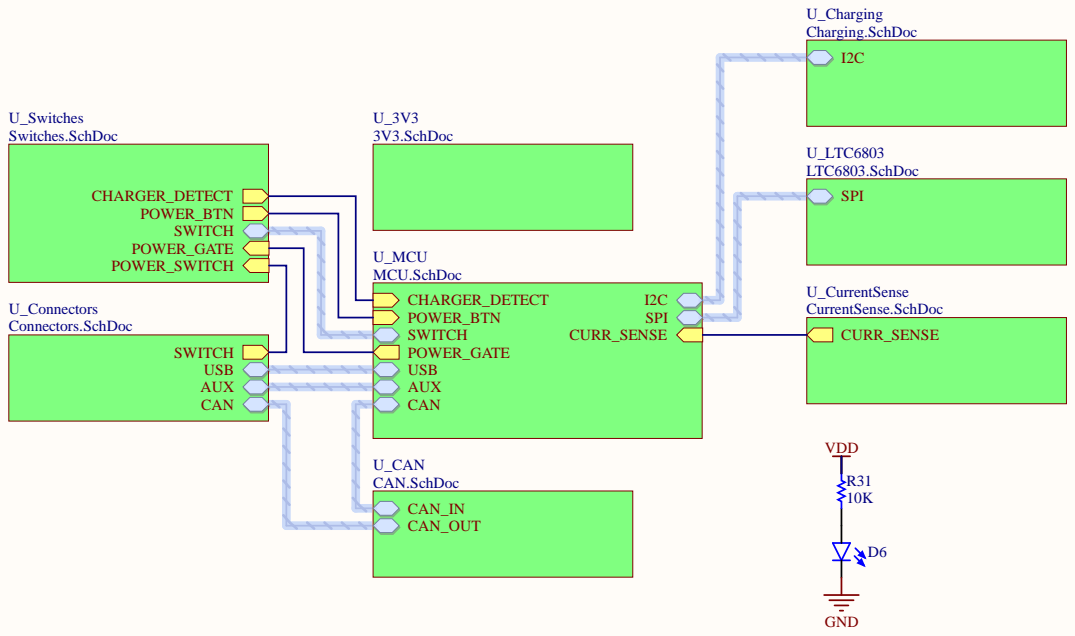
[picture p24: page 1]

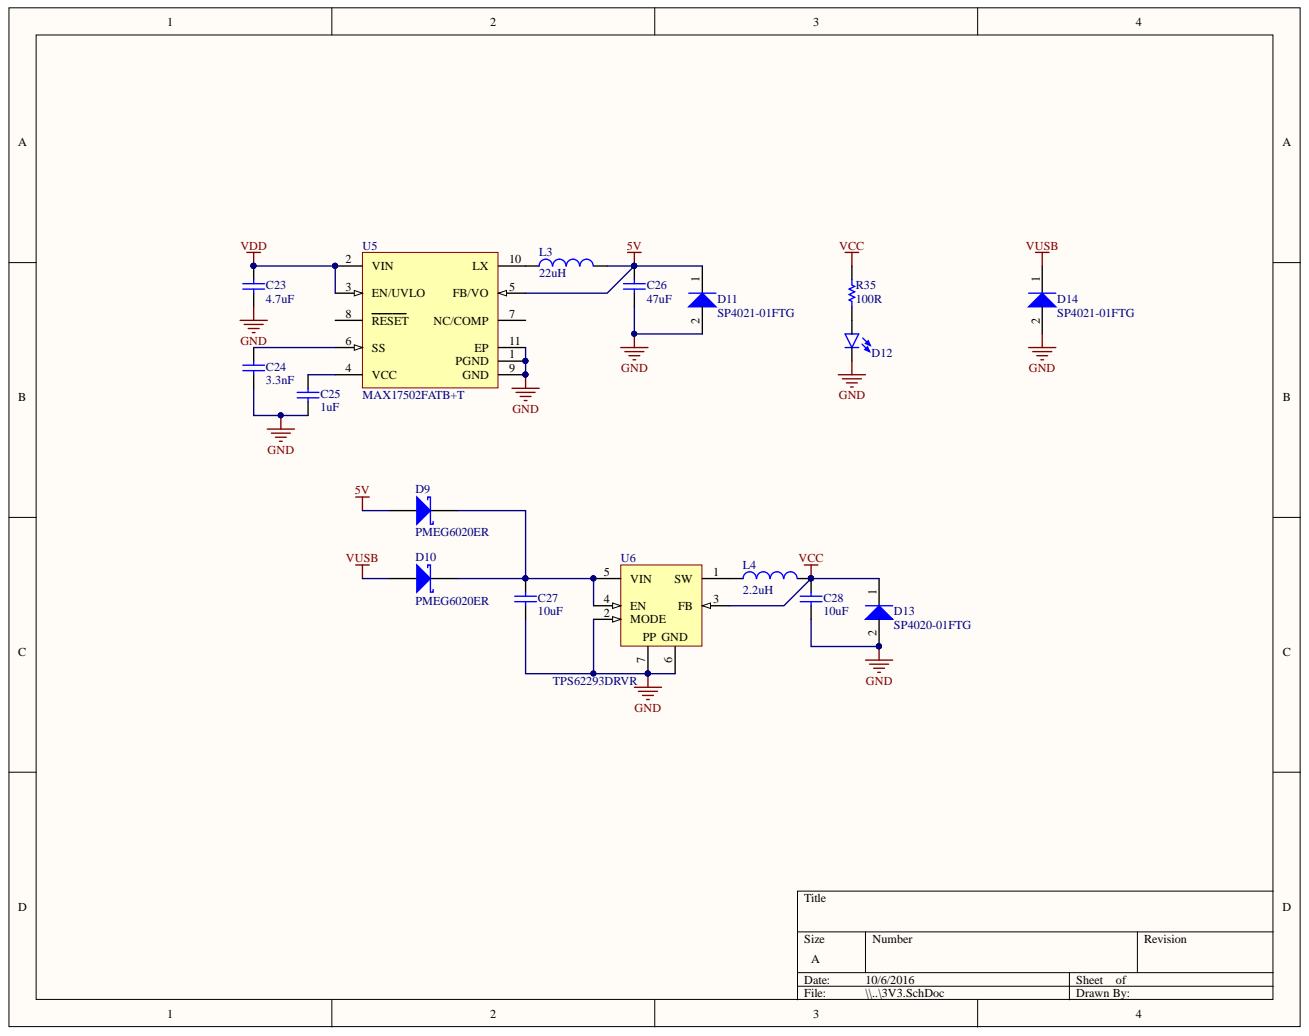
[picture p25: page 2]

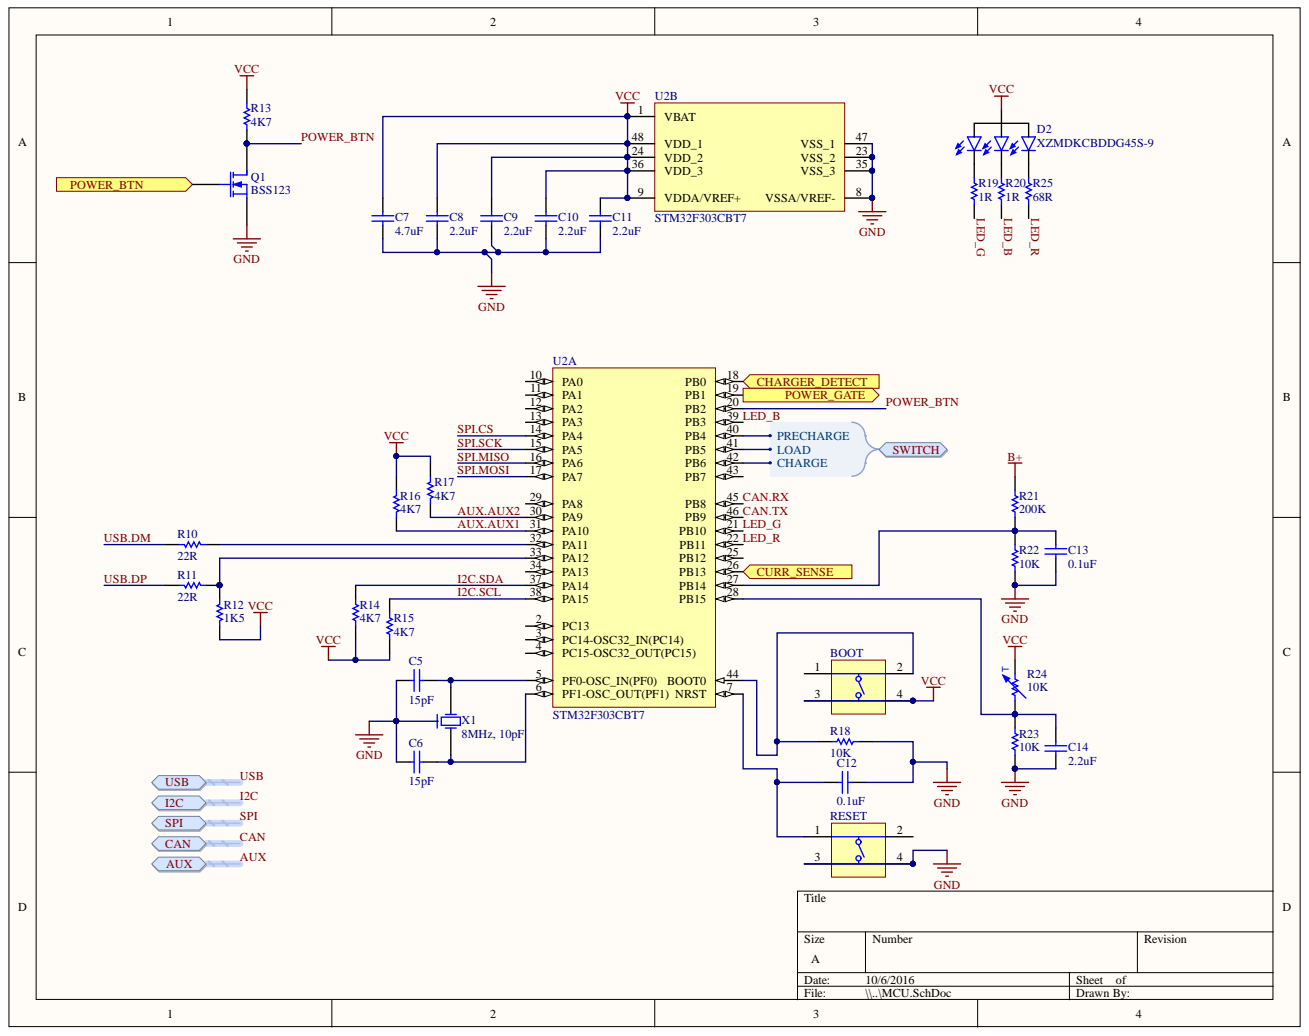
[picture p26: page 3]

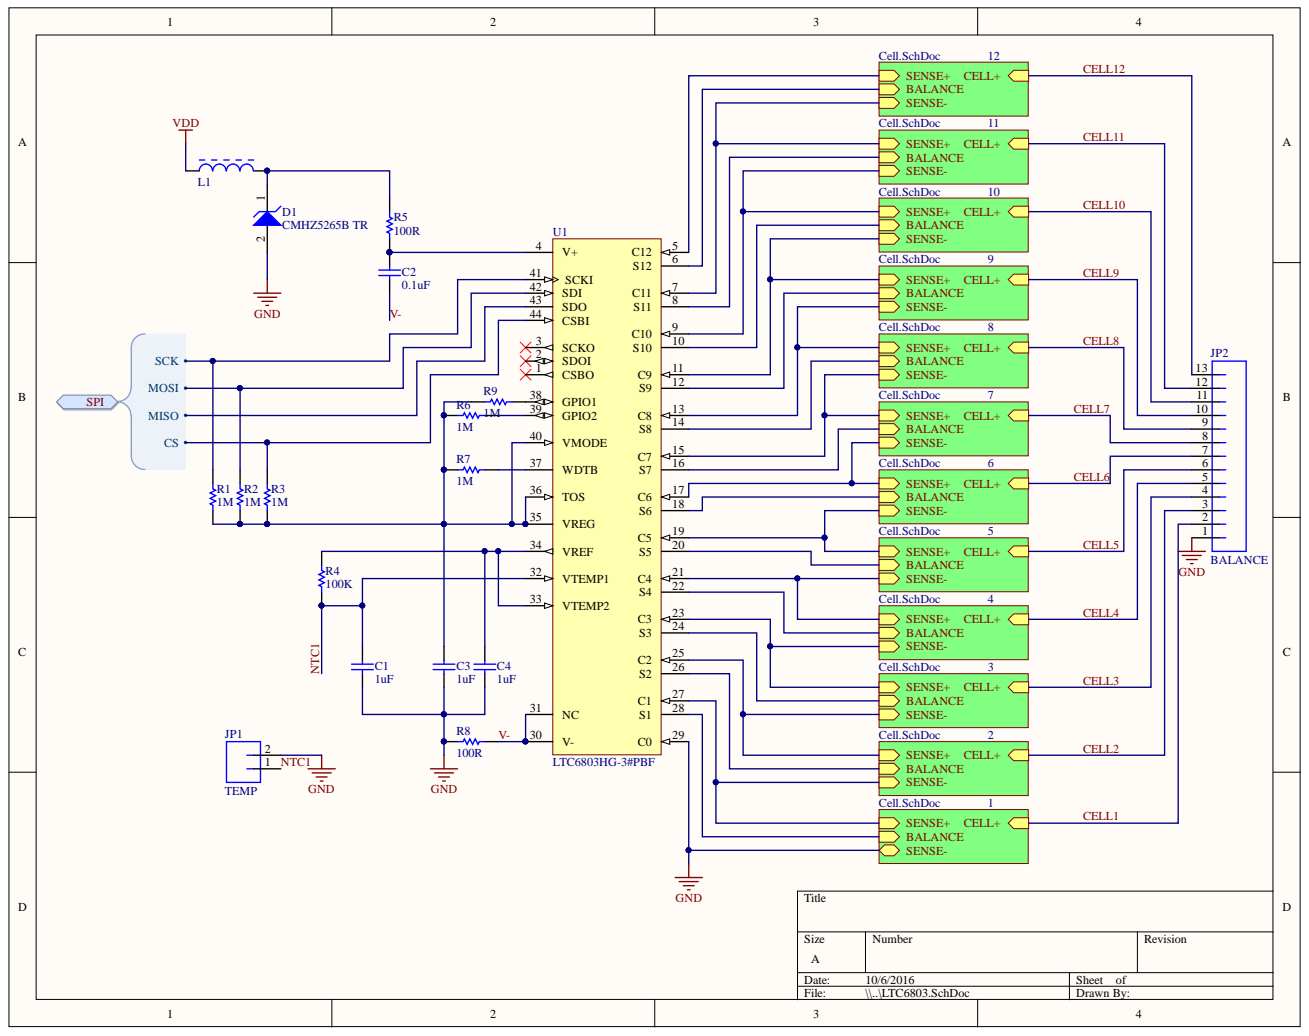
[picture p27: page 4]

6 | Ce l l . S chDoc 9
7 | CE L L + BALANCE

S E N S E + CE L L + BA L A NCE S E N S E -Ce l l . S chDoc 7 S E N S E + CE L L + BA L A NCE S E N S E -

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

Ce l l . S chDoc 4

Ce l l . S chDoc 3

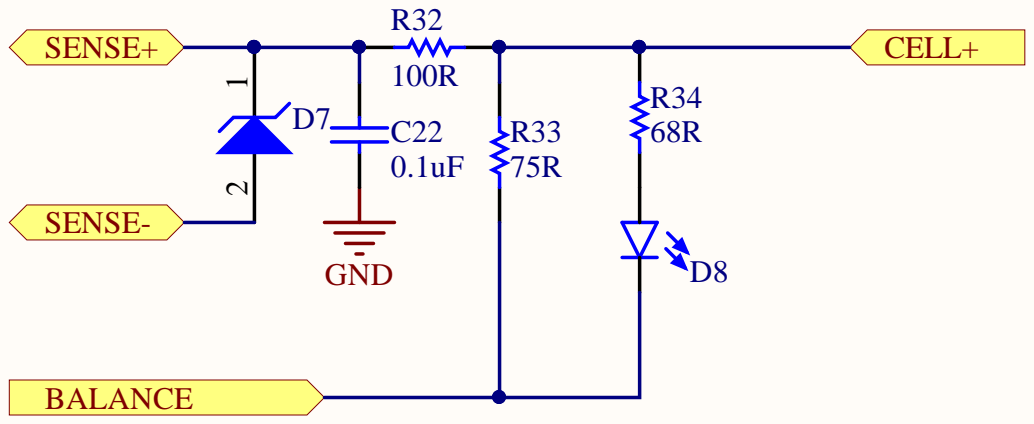
[picture p28: page 5]

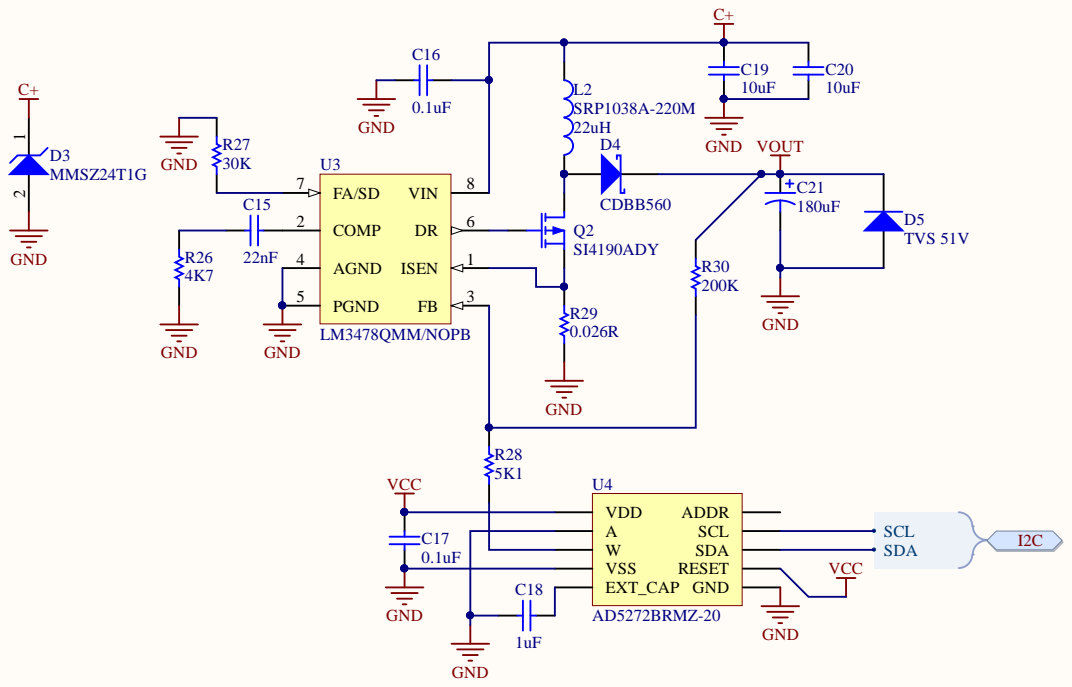
[picture p29: page 6]

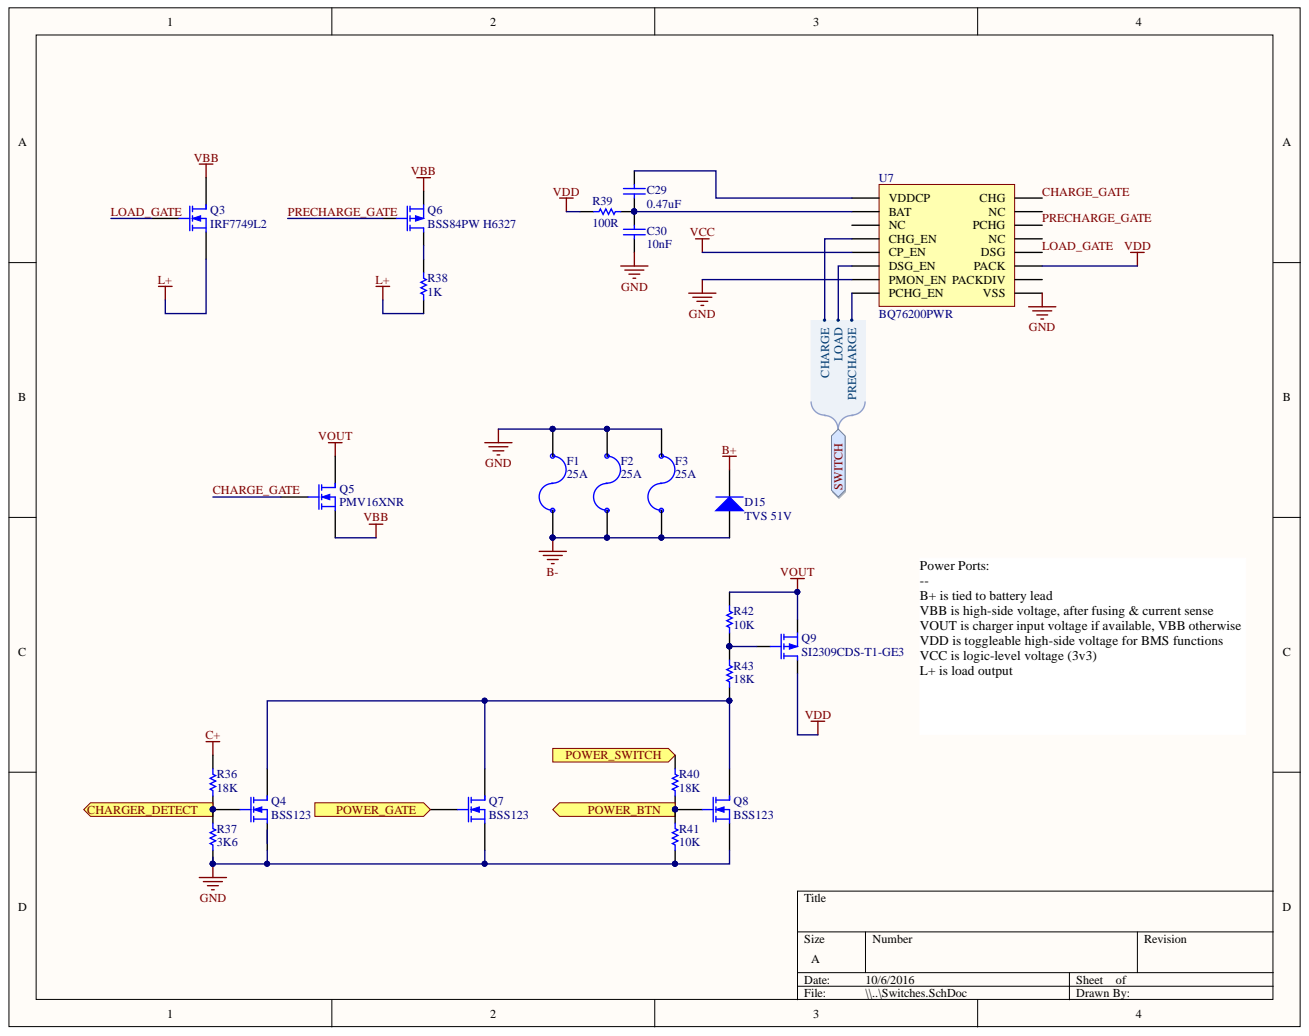
[picture p30: page 7]

Power Ports:
B+ is tied to battery lead
VBB is high-side voltage, after fusing & current sense
VOUT is charger input voltage if available, VBB otherwise
VDD is toggleable high-side voltage for BMS functions
VCC is logic-level voltage (3v3)
L+ is load output

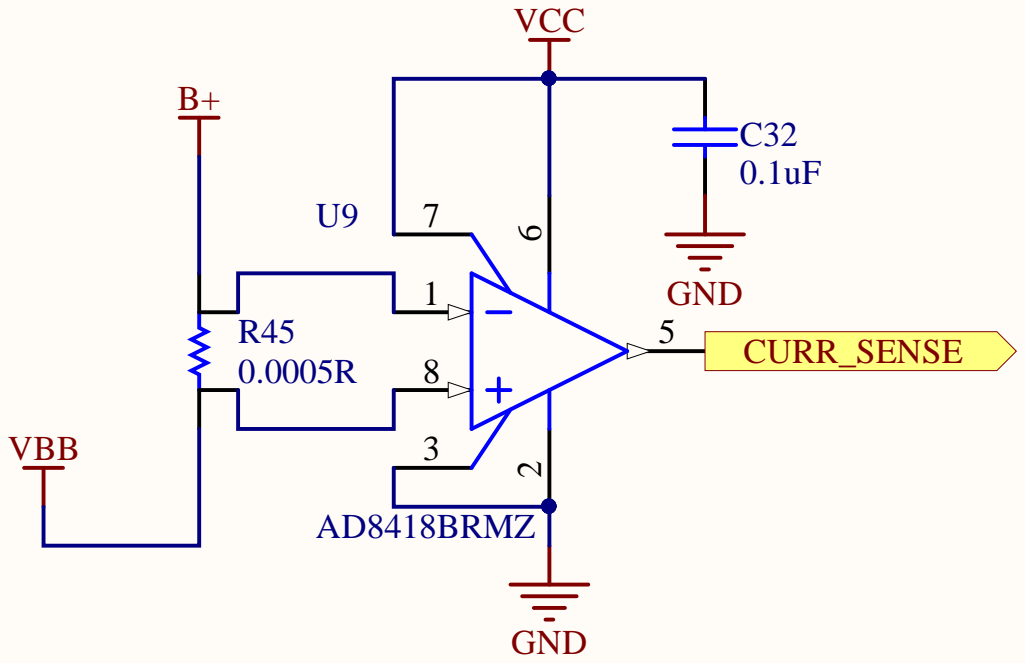
[picture p31: page 8]

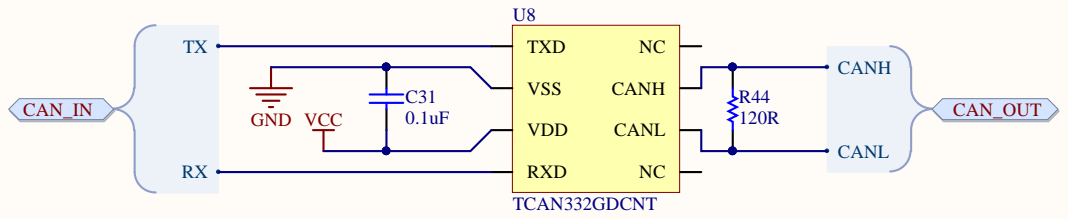
[picture p32: page 9]

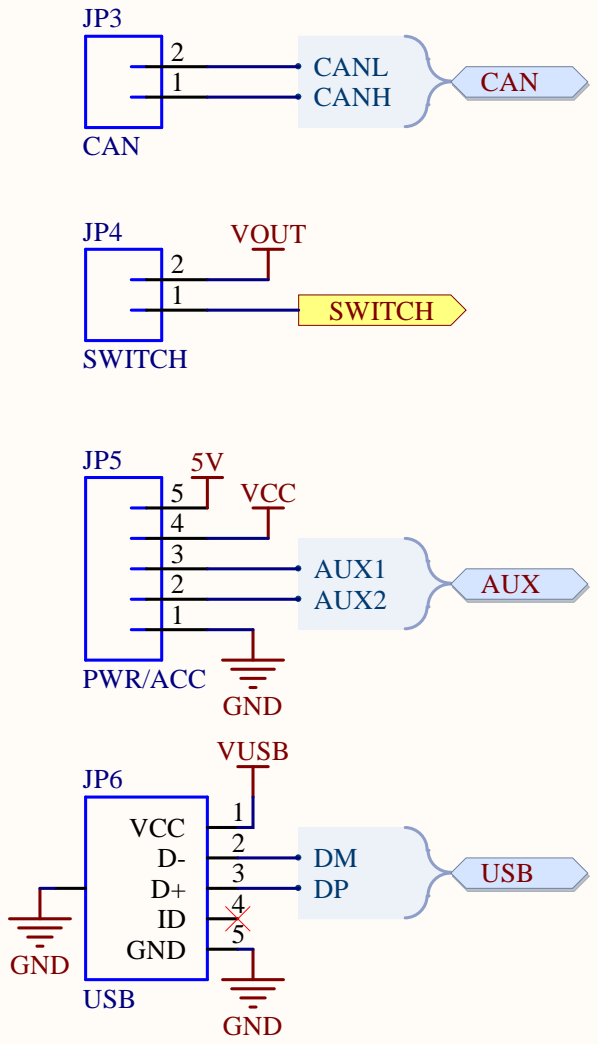
[picture p33: page 10]

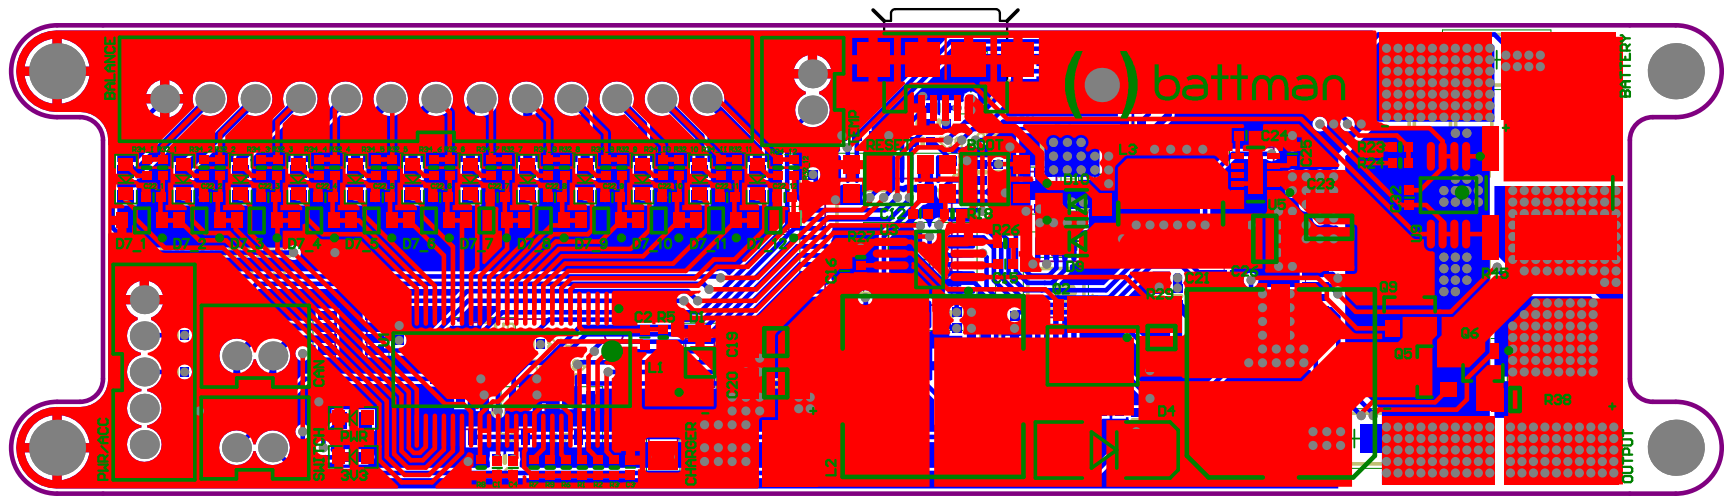
[picture p34: page 11]
