raphaelchang/battman-hardware/OldVersions/V1/pcb/BMS/BMS.pdf

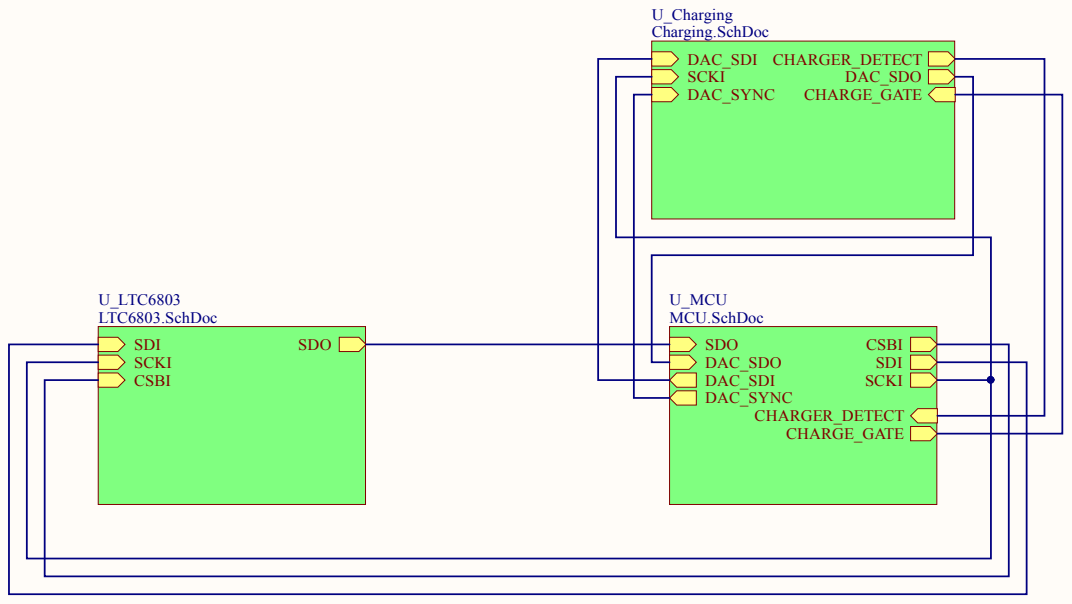
[picture p35: page 1]

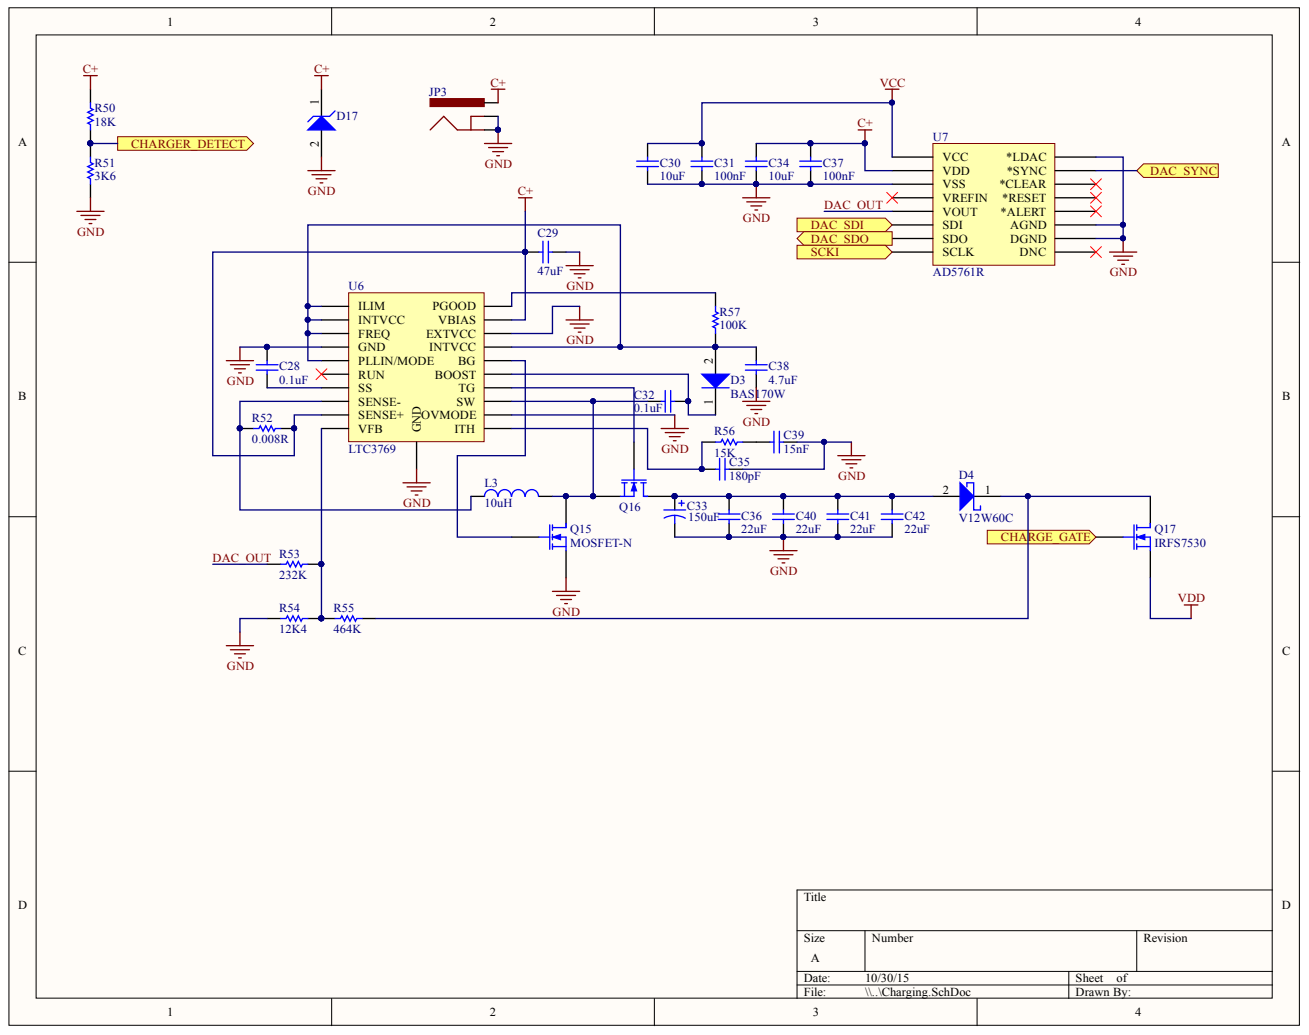
[picture p36: page 2]

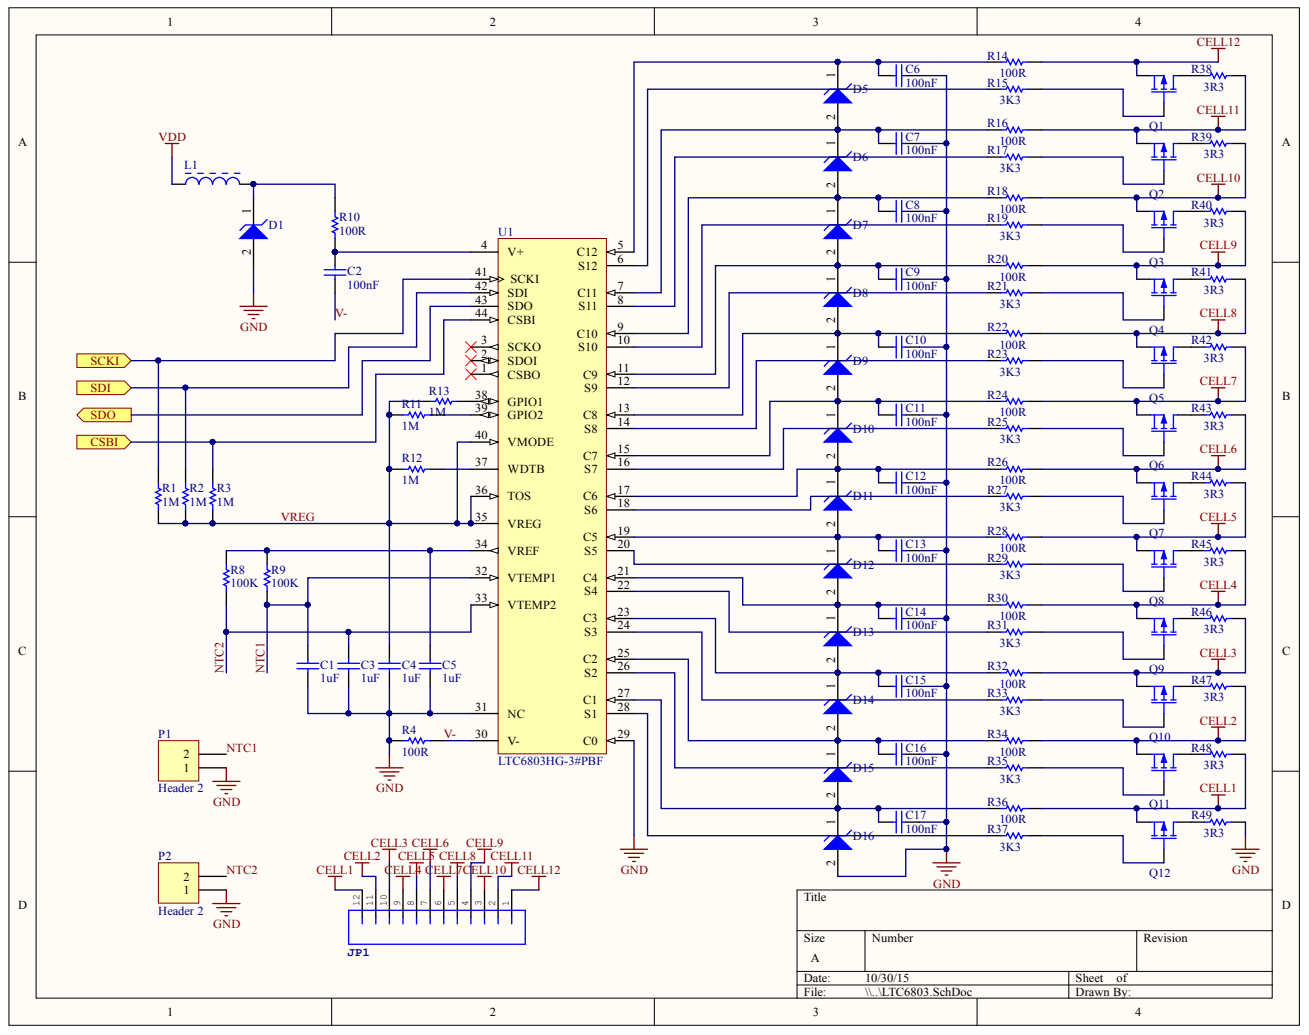
[picture p37: page 3]

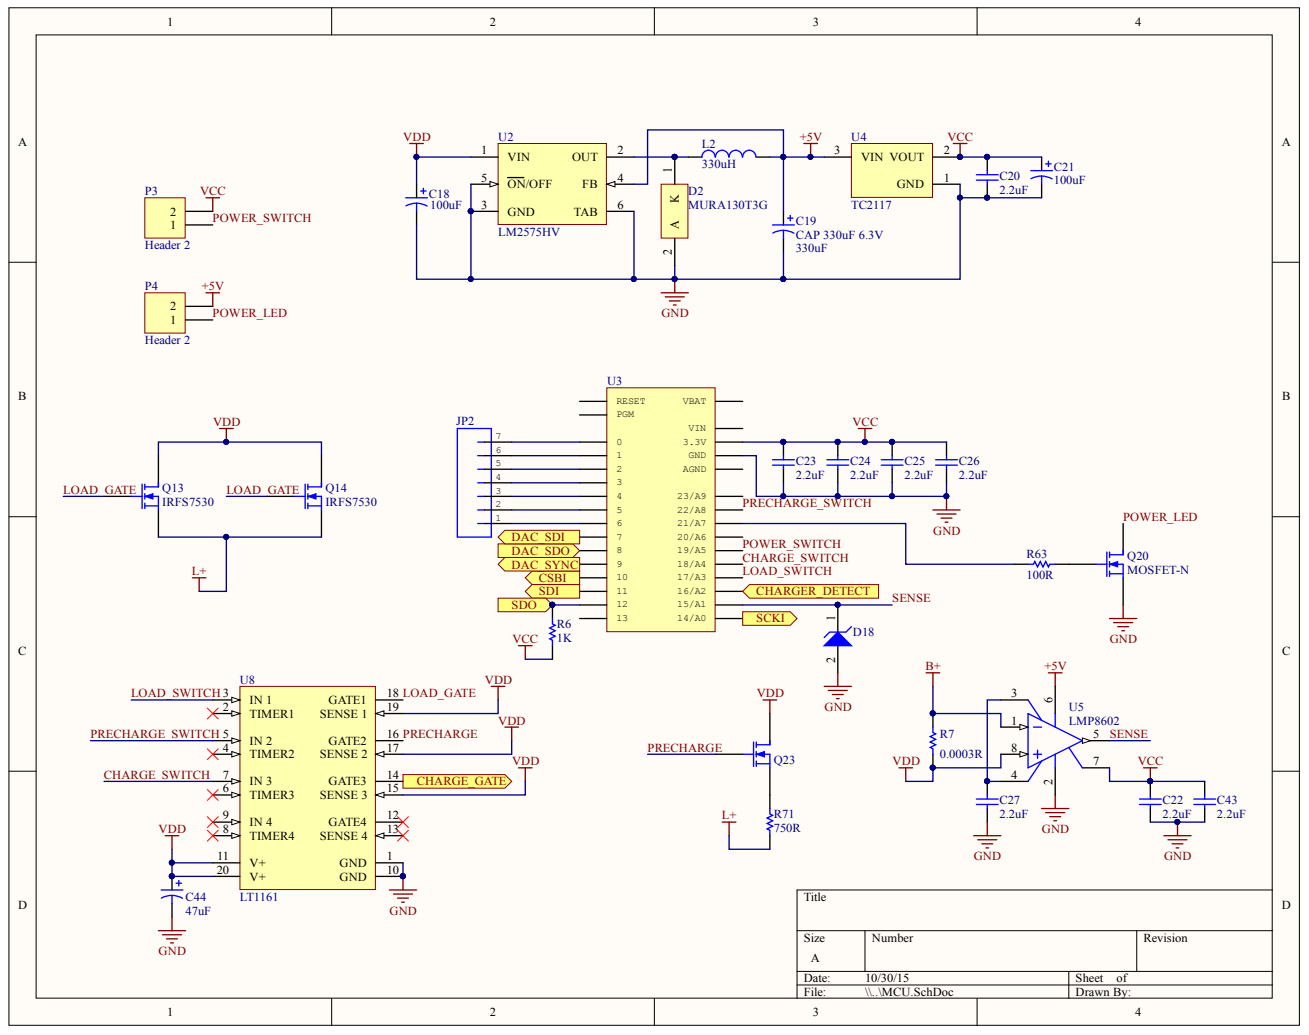
[picture p38: page 4]

C19 CAP 330uF 6.3V 330uF

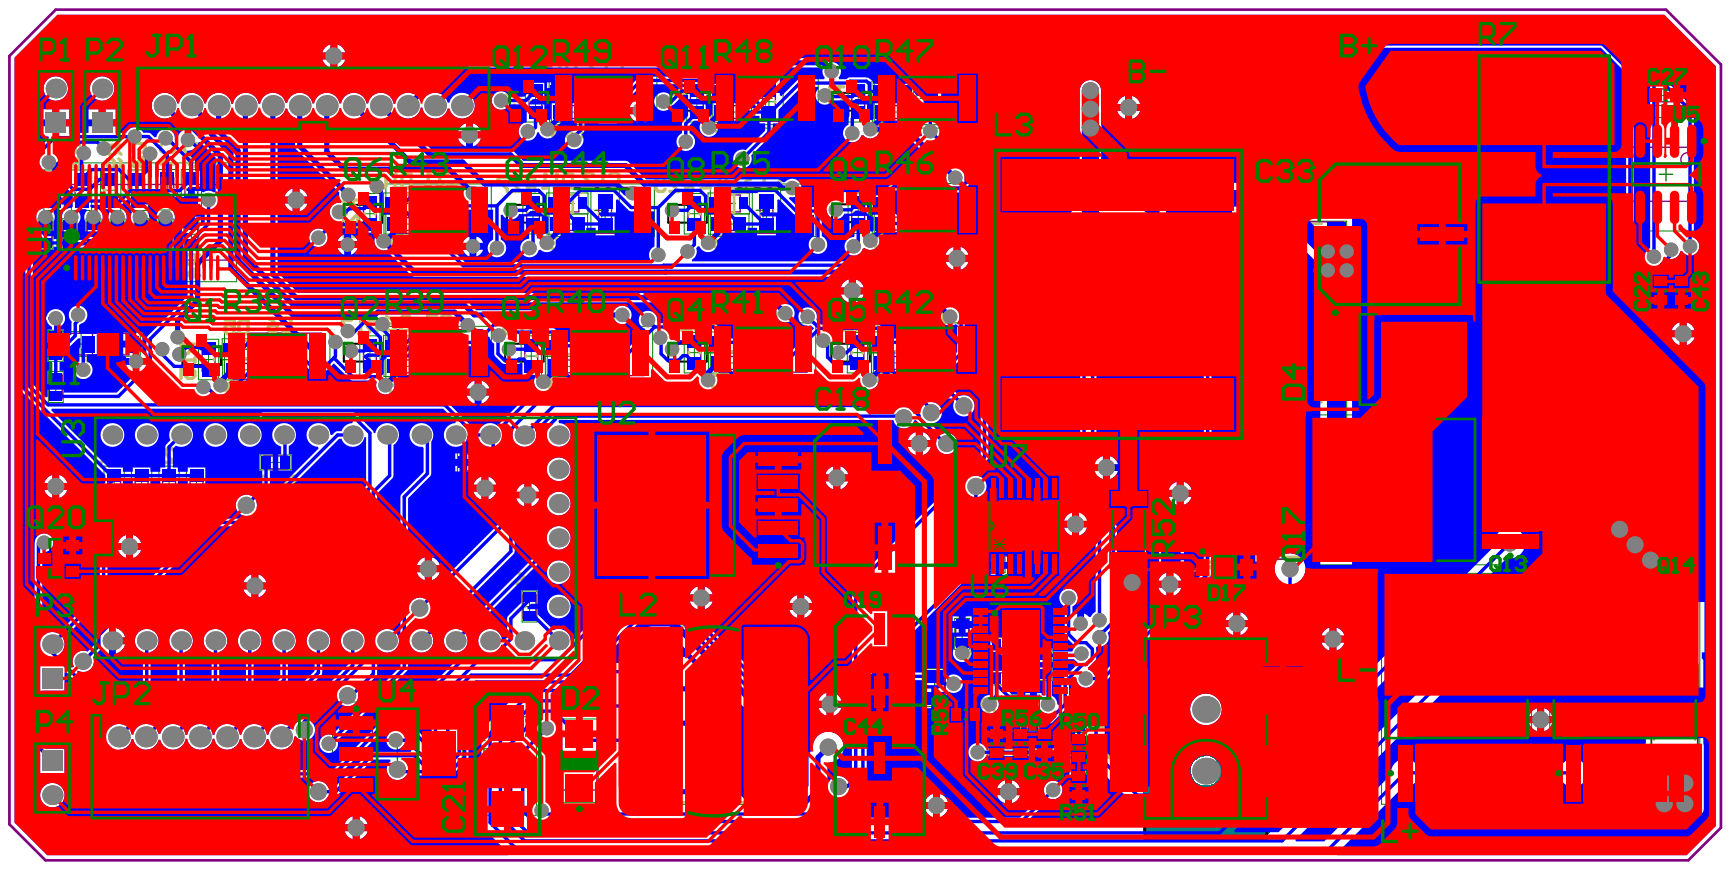
[picture p39: page 5]
