raphaelchang/battman-hardware/OldVersions/V3/Charging.pdf

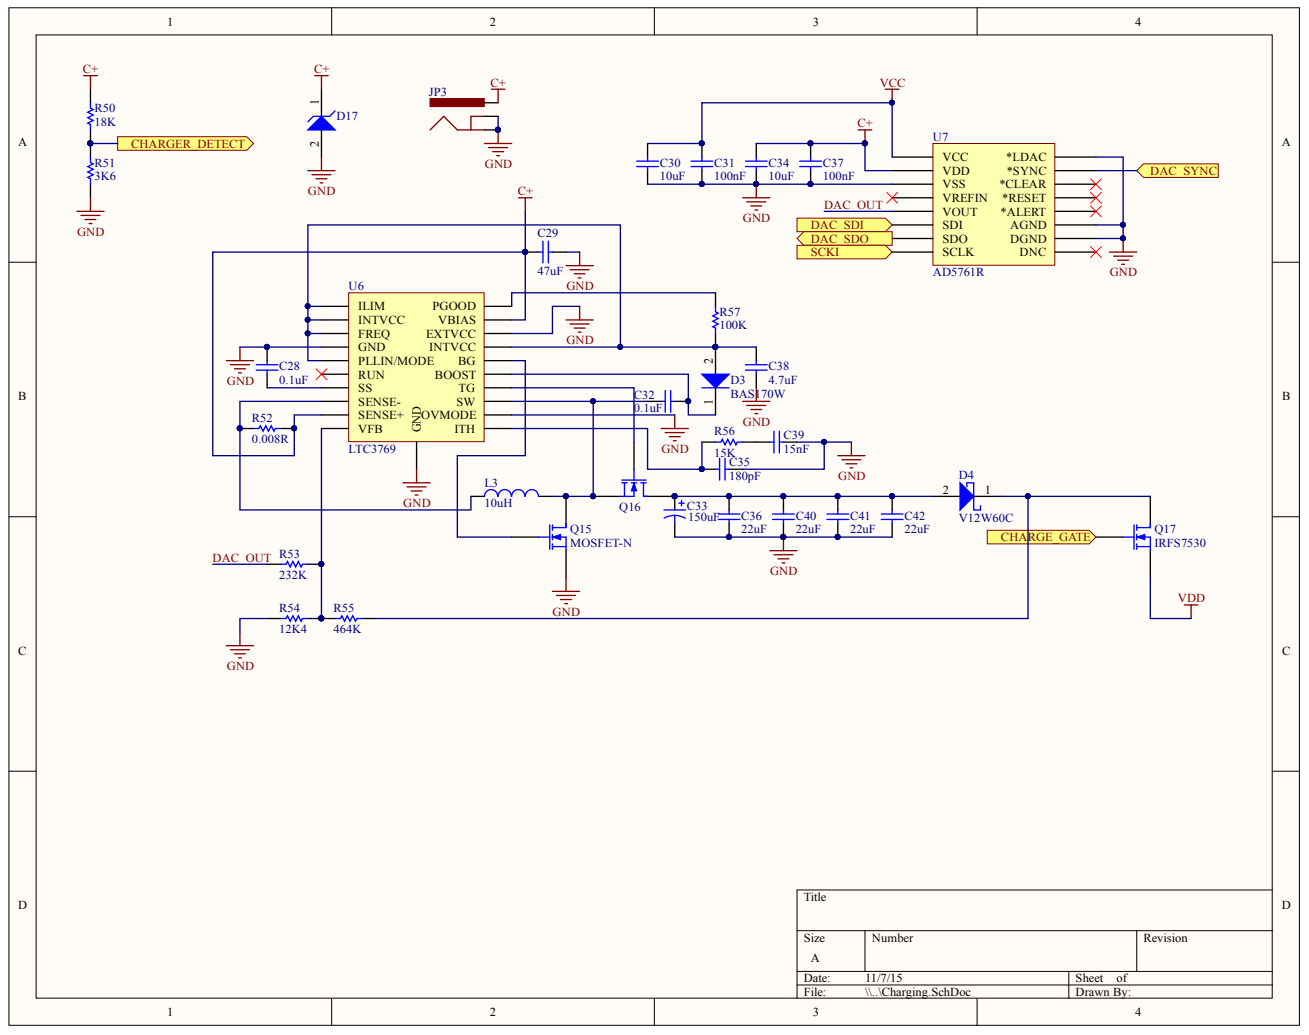
[picture p40: page 1]
