raphaelchang/battman-hardware/(list of files, drawings)

Other design files:
BMS/3V3.SchDoc
BMS/Battman.PrjPcb
BMS/BMS.SchDoc
BMS/Buzzer.SchDoc
BMS/CAN.SchDoc
BMS/Cell.SchDoc
BMS/Charging.SchDoc
BMS/Components.SchLib
BMS/Connectors.SchDoc
BMS/CurrentSense.SchDoc
BMS/Flash.SchDoc
BMS/Footprints.PcbLib
BMS/LTC6803.SchDoc
BMS/MCU.SchDoc
BMS/Power.SchDoc
BMS/RTCC.SchDoc
BMS/Switches.SchDoc
OldVersions/V1/pcb/BMS/BMS.PcbDoc
OldVersions/V1/pcb/BMS/BMS.PrjPcb
OldVersions/V1/pcb/BMS/BMS.SchDoc
OldVersions/V1/pcb/BMS/Charging.SchDoc
OldVersions/V1/pcb/BMS/Components.SchLib
OldVersions/V1/pcb/BMS/Footprints.PcbLib
OldVersions/V1/pcb/BMS/LTC6803.SchDoc
OldVersions/V1/pcb/BMS/MCU.SchDoc
OldVersions/V2/pcb/BMS/BMS.PcbDoc
OldVersions/V2/pcb/BMS/BMS.PrjPcb
OldVersions/V2/pcb/BMS/BMS.SchDoc
OldVersions/V2/pcb/BMS/Charging.SchDoc
OldVersions/V2/pcb/BMS/Components.SchLib
OldVersions/V2/pcb/BMS/Footprints.PcbLib
OldVersions/V2/pcb/BMS/LTC6803.SchDoc
OldVersions/V2/pcb/BMS/MCU.SchDoc
OldVersions/V3/BMS.PcbDoc
OldVersions/V3/BMS.PrjPcb
OldVersions/V3/BMS.SchDoc
OldVersions/V3/Cell.SchDoc
OldVersions/V3/Charging.SchDoc
OldVersions/V3/Components.SchLib
OldVersions/V3/Footprints.PcbLib
OldVersions/V3/LTC6802.SchDoc
OldVersions/V3/LTC6803.SchDoc
OldVersions/V3/MAX17502.SchDoc
OldVersions/V3/MCU.SchDoc
OldVersions/V3/Power.SchDoc
OldVersions/V4.1/3V3.SchDoc
OldVersions/V4.1/Battman.PrjPcb
OldVersions/V4.1/BMS.SchDoc
OldVersions/V4.1/Buzzer.SchDoc
OldVersions/V4.1/CAN.SchDoc
OldVersions/V4.1/Cell.SchDoc
OldVersions/V4.1/Charging.SchDoc
OldVersions/V4.1/Components.SchLib
OldVersions/V4.1/Connectors.SchDoc
OldVersions/V4.1/CurrentSense.SchDoc
OldVersions/V4.1/LTC6803.SchDoc
OldVersions/V4.1/MCU.SchDoc
OldVersions/V4.1/Power.SchDoc
OldVersions/V4.1/Project Outputs for Battman/BMS.PCB
OldVersions/V4.1/RTCC.SchDoc
OldVersions/V4.1/Switches.SchDoc
OldVersions/V4/3V3.SchDoc
OldVersions/V4/Battman.PrjPcb
OldVersions/V4/BMS.SchDoc
OldVersions/V4/CAN.SchDoc
OldVersions/V4/Cell.SchDoc
OldVersions/V4/Charging.SchDoc
OldVersions/V4/Components.SchLib
OldVersions/V4/Connectors.SchDoc
OldVersions/V4/CurrentSense.SchDoc
OldVersions/V4/Footprints.PcbLib
OldVersions/V4/LTC6803.SchDoc
OldVersions/V4/MCU.SchDoc
OldVersions/V4/Switches.SchDoc
