raphaelchang/battman-hardware/(commit log)

2016-06-15 Squashed commits before migration - Finished BMS schematic, started layout - Mostly done with BMS layout - Cleanup - Replaced parts for availability - Added name - Finalized with small changes - Star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
    [BMS.GBL, BMS.GBO, BMS.GBP, BMS.GBS, BMS.GKO, BMS.GTL, BMS.GTO, BMS.GTP]
2016-06-15 Added CAD models
    [BMS.PcbDoc, Components.SchLib, Footprints.PcbLib, MCU.SchDoc]
2016-06-25 Starting V3
    [BMS.GBL, BMS.GBO, BMS.GBP, BMS.GBS, BMS.GKO, BMS.GTL, BMS.GTO, BMS.GTP]
2016-06-25 fixed logic-side turn-on fet for charging
    [Charging.SchDoc]
2016-06-27 fixed logic level for ADC/system-wide spi bus
    [MCU.SchDoc]
2016-06-27 switched to 3v3 buck converter & removed 5v line
    [Charging.SchDoc, LTC6803.SchDoc, MCU.SchDoc]
2016-06-28 removed second n-fet for primary load
    [MCU.SchDoc]
2016-06-29 buck converter rework
    [MCU.SchDoc]
2016-07-01 schematic reorganization
    [BMS.SchDoc, LTC6803.SchDoc, MCU.SchDoc]
2016-07-04 microncontroller overhaul teensy 3 -> stm32f303
    [BMS.PrjPcb, BMS.SchDoc, LTC6803.SchDoc, MCU.SchDoc]
2016-07-05 modularizing ltc6803 schematic
    [BMS.SchDoc, Cell.SchDoc, LTC6803.SchDoc, MCU.SchDoc, Power.SchDoc]
2016-07-05 connector rework
    [Components.SchLib, Footprints.PcbLib, LTC6803.SchDoc, MCU.SchDoc, Power.SchDoc]
2016-07-06 fixed balancing sheet designators
    [BMS.PcbDoc, LTC6803.SchDoc]
2016-07-06 added balancing indicator LEDs
    [BMS.PcbDoc, BMS.PrjPcb, Cell.SchDoc, LTC6803.SchDoc]
2016-07-09 prelim layout for balancing circuit
    [BMS.PcbDoc, Cell.SchDoc, LTC6803.SchDoc, Power.SchDoc]
2016-07-09 offset correction
    [BMS.PcbDoc]
2016-07-10 footprint & component fixes fixed mismatched pins, missing footprints, etc
    [BMS.PcbDoc, BMS.SchDoc, Components.SchLib, Footprints.PcbLib, MCU.SchDoc, Power.SchDoc]
2016-07-12 ltc layout & routing
    [BMS.PcbDoc, LTC6803.SchDoc, Power.SchDoc]
2016-07-16 added usb connector
    [MCU.SchDoc]
2016-07-17 stm32 layout + routing
    [BMS.PcbDoc, BMS.PrjPcb, Cell.SchDoc, Components.SchLib, Footprints.PcbLib, LTC6803.SchDoc, MCU.SchDoc]
2016-07-18 standardizing to 0603
    [BMS.PcbDoc, Cell.SchDoc, MCU.SchDoc, Power.SchDoc]
2016-07-23 Added new shunt amplifier & smt fuse components
    [Components.SchLib, Footprints.PcbLib]
2016-07-23 Current sense rework + safety features LTC1999 -> AD8418
    [Power.SchDoc]
2016-07-23 Updating clearances for oshpark
    [BMS.PcbDoc]
2016-07-24 buck converter fixes & schematic restructuring
    [BMS.PrjPcb, MAX17502.SchDoc, Power.SchDoc]
2016-07-24 starting layout for power components
    [BMS.PcbDoc]
2016-07-25 power schematic improvements
    [BMS.PcbDoc, LTC6803.SchDoc, MCU.SchDoc, Power.SchDoc]
2016-07-26 rough layout + routing for cc/cv charger
    [BMS.PcbDoc, Charging.SchDoc]
2016-07-28 reworked boost converter layout
    [BMS.PcbDoc, Charging.SchDoc, Footprints.PcbLib, MAX17502.SchDoc, Power.SchDoc]
2016-07-29 organizing rooms; rough overall layout
    [BMS.PcbDoc]
2016-07-31 finished v3 bms (needs review)
    [BMS.PcbDoc, Components.SchLib, Footprints.PcbLib, LTC6803.SchDoc, Power.SchDoc]
2016-08-02 layout optimizations (wip)
    [BMS.PcbDoc, Charging.SchDoc, Components.SchLib, Footprints.PcbLib, MAX17502.SchDoc, Power.SchDoc]
2016-08-03 CAN transciever + shunt footprint swap
    [BMS.PcbDoc, Components.SchLib, Footprints.PcbLib, MCU.SchDoc, Power.SchDoc]
2016-08-03 restarting power room layout
    [BMS.PcbDoc]
2016-08-04 power room layout
    [BMS.PcbDoc, Power.SchDoc]
2016-08-05 finished routing
    [BMS.PcbDoc, Power.SchDoc]
2016-08-06 designators, glossing, & routing tweaks
    [MCU.SchDoc]
2016-08-07 Improved aesthetics -- 3d models + glossing
    [Footprints.PcbLib]
2016-08-08 design review pt 2
    [Power.SchDoc]
2016-08-08 minor pre-fab tweaks
    [BMS.GBL, BMS.GBO, BMS.GBP, BMS.GBS, BMS.GKO, BMS.GTL, BMS.GTO, BMS.GTP]
2016-08-09 added some notes on charge current adjustment
    [BMS.PcbDoc, Charging.SchDoc]
2016-08-21 renumbered schematics & pdf export
    [BMS.PcbDoc, BMS.SchDoc, Cell.SchDoc, Charging.SchDoc, LTC6803.SchDoc, MAX17502.SchDoc, MCU.SchDoc, Power.SchDoc]
2016-08-27 fixing io types (minor)
    [BMS.PcbDoc, BMS.PrjPcb, BMS.SchDoc, Charging.SchDoc, MCU.SchDoc, Power.SchDoc]
2016-10-03 Finished V4
    [3V3.SchDoc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]
2016-10-03 Remove old folder
    [BMS.GBL, BMS.GBO, BMS.GBP, BMS.GBS, BMS.GKO, BMS.GTL, BMS.GTO, BMS.GTP]
2016-10-03 Add PDF
    [3V3.SchDoc, BMS.SchDoc, Battman.PrjPcb, CAN.SchDoc, Cell.SchDoc, Charging.SchDoc, Connectors.SchDoc, CurrentSense.SchDoc]
2016-10-03 Update project file
    [Battman.PrjPcb]
2016-10-03 Small change
    [BMS.SchDoc]
2016-10-05 Library and cosmetic changes
    [3V3.SchDoc, Cell.SchDoc, Charging.SchDoc, CurrentSense.SchDoc, Footprints.PcbLib, LTC6803.SchDoc, MCU.SchDoc, Switches.SchDoc]
2016-10-05 Add all part numbers
    [Battman.PrjPcb, Battman.xls, Battman.xlsx, Cell.SchDoc, Charging.SchDoc, Components.SchLib, Connectors.SchDoc, CurrentSense.SchDoc]
2016-10-05 Fixed precharge fet
    [Switches.SchDoc]
2016-10-06 Finalized v4.0
    [BMS.GBL, BMS.GBO, BMS.GBP, BMS.GBS, BMS.GKO, BMS.GTL, BMS.GTO, BMS.GTP]
2016-10-08 Balancing fixes for 4.1
    [3V3.SchDoc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]
2016-10-10 Layout changes
    [3V3.SchDoc, Charging.SchDoc, Footprints.PcbLib, Switches.SchDoc]
2016-10-20 Added RTCC for periodic wake
    [3V3.SchDoc, BMS.SchDoc, Battman.PrjPcb, Battman.xls, CAN.SchDoc, Cell.SchDoc, Charging.SchDoc, Components.SchLib]
2016-10-21 Gain selection circuit for current amplifier
    [BMS.SchDoc, CurrentSense.SchDoc, MCU.SchDoc]
2016-10-22 BOM changes
    [BMS.PCB, Battman.PrjPcb, Battman.xls, Battman.xlsx, Charging.SchDoc, Connectors.SchDoc, CurrentSense.SchDoc, Switches.SchDoc]
2016-10-24 MOSFET driver and SPI fix
    [BMS.SchDoc, Battman.PrjPcb, Charging.SchDoc, Connectors.SchDoc, LTC6803.SchDoc, MCU.SchDoc, Switches.SchDoc]
2016-10-25 Upgraded current sense IC
    [BMS.SchDoc, Battman.PrjPcb, CurrentSense.SchDoc, MCU.SchDoc]
2016-10-26 Changed power monitor again and fixed MOSFET driver circuit
    [Battman.PrjPcb, CurrentSense.SchDoc, MCU.SchDoc, Switches.SchDoc]
2016-10-27 Changed charge voltage controller to DAC
    [Battman.PrjPcb, Charging.SchDoc, Switches.SchDoc]
2016-10-27 Update BOM
    [Battman.xls, Switches.SchDoc]
2016-10-29 Final tweaks
    [3V3.SchDoc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]
2016-10-29 Finalized V4.1
    [BMS.GBL, BMS.GBO, BMS.GBP, BMS.GBS, BMS.GKO, BMS.GTL, BMS.GTO, BMS.GTP]
2016-10-30 Paste mask expansion for mounting holes
    [BMS.GBL, BMS.GBP, BMS.GTL, BMS.GTP]
2016-11-10 Started v4.2 with charge component changes and discharge LED
    [3V3.SchDoc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]
2016-11-12 Precharge fix
    [BMS.PCB, BMS.SchDoc, Battman.xls, Battman.xlsx, Bill of Materials-Battman.xls, Charging.SchDoc, RTCC.SchDoc, Switches.SchDoc]
2016-11-25 Changed charger IC and added flash memory
    [BMS.GBL, BMS.GBO, BMS.GBP, BMS.GBS, BMS.GKO, BMS.GTL, BMS.GTO, BMS.GTP]
2016-11-25 Fix some cap voltage limits
    [Bill of Materials-Battman.xls, Switches.SchDoc]
2016-12-02 Finalized 4.2
    [BMS.GBL, BMS.GBO, BMS.GBP, BMS.GBS, BMS.GKO, BMS.GTL, BMS.GTO, BMS.GTP]
2020-12-25 Old changes
    [BMS.GBL, BMS.GBO, BMS.GBP, BMS.GBS, BMS.GKO, BMS.GTL, BMS.GTO, BMS.GTP]
